alexandercoabad/AgilA32_PIO/README.md

    

# AgilA32 — an RV32I CPU with RP2040-compatible PIO for Tiny Tapeout (IHP SG13CMOS5L shuttle)

> **In one line:** an RV32I CPU written for this project, with RP2040-compatible
> PIO state machines on the same die, so the CPU can load, *and later replace*,
> the protocol engines at run time -- and can then halt itself while the PIO
> keeps running the protocol on its own.
>
> **Originality:** The CPU is written for this project, not derived from an existing open-source core; it follows the public RV32I specification, and the PIO follows the public RP2040 datasheet.
>
> **Third-party material:** the PIO block is an independent implementation, not affiliated with or endorsed by Raspberry Pi Ltd; "Raspberry Pi", "RP2040" and "Pico" are Raspberry Pi's trademarks, used only to say what the block is compatible with. Some programs in `pio/` are derived from the Pico SDK / pico-examples (BSD-3-Clause); see [`NOTICE.md`](NOTICE.md).
>
> Developed by Alexander Co Abad with the help of Claude AI (Sonnet 5.5).

Originally inspired by [Pineapple ONE](https://pineapple-one.github.io/),
a RISC-V CPU built entirely out of discrete 7400-series logic chips (no
FPGA, no microcontroller) -- the "just basic logic" idea of a minimal
RISC-V core is where this whole line of projects started.

## Try it and program it

- **Browser simulator** (the real RTL compiled to WebAssembly, with waveform, block diagram, LEDs, 7-segment display and example programs): https://alexandercoabad.github.io/agila32/
- **C and assembly programs**: `c/` holds a small C flow for the 44-byte GPIO-bootloader window with examples (blink, counter, chase, switches, PILIPINAS LASALLE on a 7-segment display); see `c/README.md`.
- **Submission checklist** with the evidence for each requirement: `SUBMISSION.md`.

## Protocol coverage

**Test counts** (all run by `make standalone-tests` in `test/`, and on every push by `.github/workflows/pio-tests.yaml`): **120 cocotb protocol tests**
(`test/test_pio_protocols.py`, `test_pio_swd.py` and `test_pio_can.py`, via `Makefile.proto`) **plus 17 PIO Verilog
testbenches**: 13 CPU-driven top-level demos (`tb_pio_cpu_uart.v`,
`tb_pio_cpu_i2c.v`, `tb_pio_cpu_multi.v`, `tb_pio_cpu_spi4.v`, `tb_pio_cpu_jtag.v`, `tb_pio_cpu_usb.v`, `tb_pio_cpu_i2c_slave.v`, `tb_pio_cpu_ps2.v`, `tb_pio_cpu_ws2812.v`, `tb_pio_cpu_ws2812_repeat.v`, `tb_pio_cpu_onewire.v`, `tb_pio_cpu_vga.v`, `tb_pio_cpu_can.v`) and 4 that
drive `pio.v` directly (`tb_pio_isa.v`, `tb_pio_uart.v`, `tb_pio_spi.v`, `tb_pio_vga.v`).

**Formal proofs and random tests** (added 30 Oct 2026, no change to `src/`): four unbounded SymbiYosys proofs of the PIO FIFO
(`pio_fifo.v`) and of one state machine (`pio_sm.v`) in `formal/` -- **all four pass** in the manual GitHub workflow `formal.yaml`
(run #3, 30 Oct 2026, commit `f03db8d`, 2 min 20 s) -- and 64 constrained-random cocotb protocol tests per seed
(`test/test_pio_random.py`: UART, SPI, I2C, PS/2; `pio-tests.yaml` run #54: seeds 1-5, 5 x 64 tests passed). See "Formal verification" below.

| Protocol | Runs on | Status | Verified by |
|---|---|---|---|
| UART TX | PIO (`uart_tx`) | Done | `tb_pio_uart.v` (cycle-exact 8N1 waveform, fractional divider), cocotb (integer, fractional and averaged dividers), end-to-end CPU demo `tb_pio_cpu_uart.v` |
| UART RX | PIO (`uart_rx_mini`) | Done | `tb_pio_uart.v` (TX+RX loopback, framing-error IRQ), cocotb (framing error, baud tolerance, two-SM loopback) |
| SPI master, modes 0-3 | PIO (`spi_master`, `spi_cpha1`, `spi_cpol1_cpha0`, `spi_cpol1_cpha1`) | Done | `tb_pio_spi.v` (mode 0: SCK period, `SYNC_BYP`), cocotb `test_spi_mode0`-`test_spi_mode3` (data both ways, SCK idle level and edge count, SCK period, MOSI setup/hold, fast SCK) |
| I2C master | PIO (`i2c`) | Done | cocotb (write, read, repeated-start register read, NAK -> IRQ 0, clock stretching), CPU demo `tb_pio_cpu_i2c.v` |
| SPI modes 0-3, CPU-driven | PIO reprogrammed by CPU at run time, CPU relays data | Done | `tb_pio_cpu_spi4.v` (one image, four modes back to back: SCK idle level, 16 edges, MOSI setup/hold, CS handled by the CPU, MISO byte read by the CPU and re-sent on MOSI in the next mode) |
| JTAG master (IEEE 1149.1 TAP walk), CPU-driven | PIO (`jtag`) | Done | `tb_pio_cpu_jtag.v` (CPU resets the TAP, reads the 32-bit IDCODE, loads IR = USER, writes the 16-bit USER register with the IDCODE bits it just read, reads it back; a pins-only TAP model checks every state, scan lengths 32/4/16/16, exactly 95 TCK pulses, TDI/TMS setup and hold, and that the CPU halts only after the last pulse) |
| UART -> SPI -> I2C on one state machine | PIO, reprogrammed by CPU at run time | Done | `tb_pio_cpu_multi.v` (all three waveforms, strictly in sequence) |
| I2C slave, write direction (`i2c_slave_rx`: address match, ACK, N data bytes into the RX FIFO) | PIO, 29 of 32 words | Done in simulation; bounded to `WRITE_BYTES` per transaction by design; needs SCL period >= 32 clocks (keep >= 40) | 5 cocotb tests (write, other address / read request ignored, buffer-full NAK, repeated START, single-byte mode with 0x00/0xFF/0x01/0x80) + `tb_pio_cpu_i2c_slave.v` (see below) |
| I2C slave, read direction (`i2c_slave_tx`: address match, ACK, bytes from the TX FIFO, clock stretching while the FIFO is empty) | PIO, 32 of 32 words | Done in simulation; same SCL limit | 4 cocotb tests (4-byte read, 3000-clock stretch, writes ignored, 12-byte read with FIFO refill) + the SCL-speed sweep |
| I2C multi-master master (`i2c_mm`: bit-level arbitration, clock synchronisation) | PIO, 27 of 32 words | Done in simulation. **No bus-busy detection**: a START is issued whether or not another master is mid-transaction and can destroy that transaction (2 of 8 timings tried); the host must wait for the bus to be free first (see docs/info.md) | 10 cocotb tests (no false arbitration loss, wins, loses and releases both lines then retries, loses inside the address byte, slower second master, identical frames where neither loses, loss decided on the last bit of a byte in both directions, read-versus-write to the same address in both directions) |
| One I2C device that is both slave directions (register file: write pointer, then repeated START + read) | PIO | Not possible as is: the two slave programs need 29 + 32 words and the instruction memory has 32; they can only be swapped at run time | -- |
| I2C slave driven by the CPU: master writes `A5 3C` to 0x42, CPU reads them off the RX FIFO, adds 1, swaps the PIO to the read-slave program, halts; master reads back `A6 3D` | PIO reprogrammed by the CPU between two slave programs | Done in simulation | `tb_pio_cpu_i2c_slave.v` (ACKs, bytes, CPU parked during the read; mutation-checked: CPU adding 2 instead of 1 fails the bench) |
| PS/2 keyboard, CPU bit-bang | CPU firmware over flash pages (not PIO) | Works only against a slowed-down keyboard | `tb_ps2_reader.v`, `tb_ps2_ascii.v` (the testbench holds each CLOCK level for 4000 clocks; a real keyboard's is 30-50 us, and one flash page switch costs about 3000 clocks -- see `docs/info.md`) |
| PS/2 keyboard receiver | PIO (`ps2_rx`, own state machine) | Done in simulation, at the `pio.v` level **and CPU-driven end to end** (`tb_pio_cpu_ps2.v`: real 10 kHz keyboard at 24 MHz; the CPU sleeps while 4 frames wait in the RX FIFO, then reads all 7 scancodes) | 7 cocotb tests against a PS/2 keyboard model: keystroke traffic incl. extended keys, 10 and 16.7 kHz CLOCK, 4-frame FIFO burst while the CPU is busy, FIFO overflow + recovery, idle-timeout resync after a partial frame, bad parity / stop bit reported to the CPU, and running next to an SPI master on another state machine |
| SPI LCD (ST7789) | CPU bit-bang (not PIO) | Done | `tb_st7789_driver.v` |
| CAN 2.0A/B (11 and 29 bit identifiers, data and remote frames), CPU-assisted | PIO (`can_tx` 20 words + `can_rx` 10 words = 30 of 32, two state machines; TXD = uo_out[0], RXD = ui_in[1] of an external CAN transceiver) | Done in simulation. TX: the PIO sends a frame the CPU has already CRC'd and bit-stuffed, reads the bus back at 75 % of every bit, stops at the first mismatch (lost arbitration / bit error, reported with the bit index) and reads the ACK slot; RX: raw capture of every frame (including the chip's own) after a hard sync on SOF, decoded afterwards by the CPU (`tools/can_frame.py`). **The CRC-15 and the bit stuffing run on the CPU because PIO has no XOR**, so this is not a real-time controller: the CPU has to keep the 4-deep FIFOs fed and drained (one word per 32 bit times). Bit rate = f_clk / (16 x CLKDIV) (24 MHz: CLKDIV 3 = 500 kbit/s, 6 = 250, 12 = 125); loop delay TXD -> RXD must be 0..7 clocks. **Not done**: resynchronisation after SOF (clocks must agree to about 0.2 %), bus-idle detection before SOF, automatic ACK of received frames, error counters and automatic error frames, CAN FD; not tried on a real bus or transceiver. | 25 cocotb tests against a CAN bus model with controller nodes (hard sync, 75 % sampling, destuffing, CRC, ACK, arbitration): CRC-15 against an independent GF(2) division, stuffing rules, 3000 random frames round-trip, 8 frame types on the wire (TXD edges exactly on the 16-tick grid, integer and fractional CLKDIV), unacknowledged frame, error flag command, back-to-back commands, arbitration lost / won / at every identifier bit, bit errors both ways with recovery, loop-delay margin, SYNC_BYP, RX of every frame type word for word against a Python reference model of the RX program, back-to-back frames, every partial-word length, error flag and stuff-violation capture, 7-word frames, a 14-frame mixed session; `tb_pio_cpu_can.v` (the CPU sends a frame that a bench node acknowledges bit for bit and reads back two RX captures) + `tools/can_mutation_sweep.py` (52 mutants of the two programs and of `can_frame.py`) |
| Low-speed USB host engine (1.5 Mb/s: token/data TX with NRZI + bit stuffing + EOP, reply RX) | PIO (`usb_ls`, 29 of 32 instruction words, one state machine) | Done in simulation at 24 MHz (CLKDIV 2); receive clock tolerance only about -0.5 % to +0.8 % (see below) | 7 cocotb tests against a low-speed device model (token waveform edge-by-edge, max-stuffing DATA1, IN -> DATA1 turnaround, NAK, receiver alone, 12-packet fuzz, clock-error sweep) + `tb_pio_cpu_usb.v` (CPU queues an IN token and halts; PIO sends it, turns the bus around and captures the 8-byte reply) |
| WS2812 / SK6812 LED strip ("NeoPixel"), CPU-driven | PIO (`ws2812`, 4 instructions, one state machine) | Done in simulation at 24 MHz (CLKDIV 3); a CPU-fed frame is limited to about 5 pixels (see below); not tried on a real strip | 5 cocotb tests against a strip model that decodes bits from pulse widths (exact 375 / 875 ns pulses and 1.25 us bits, 8 pixels back to back, latch between frames, a feed gap longer than the reset time splits the frame, 32-bit RGBW) and `tb_pio_cpu_ws2812.v` (CPU preloads four pixels, enables SM0, queues a fifth and halts; no pulse at the pad hand-over, 126 us low before the first bit, PIO finishes alone); the same bench also runs an RGBW firmware (32-bit pixels) and a 280 us-reset firmware (343 us low before the first bit) |
| WS2812 long strip (repeat colour) | PIO (`ws2812_repeat`, 15 instructions, one state machine) | Done in simulation: 300 pixels from ONE pair of FIFO words; borders stretch the LOW time to 1.0-1.5 us (outside the nominal windows, not tried on a strip) | 5 cocotb tests with exact HIGH and LOW widths at every border (runs, back-to-back runs, N = 1, RGBW, latch) + `tb_pio_cpu_ws2812_repeat.v` (CPU queues three colour runs with six FIFO words and halts; the PIO sends 60 pixels alone, every pulse exact) + `tools/ws2812_repeat_mutation_sweep.py` (18 mutants, all caught) |
| 1-Wire master (Maxim/Dallas, standard speed): reset + presence, bit slots, READ ROM | PIO (`onewire`, 31 of 32 instruction words, one state machine, open-drain DQ on pad 8) | Done in simulation at 24 MHz (CLKDIV 24 = 1 us tick); no overdrive speed, no strong pull-up, ROM search would be CPU code; usable clock window about -7.7 % to +15 % | 7 cocotb tests against a 1-Wire device model that checks every pulse (reset 480-960 us, presence timing for four device timings, absent device, write-slot edges, READ ROM with CRC-8, partial bit counts, read-0 hold margin, clock-tolerance sweep) and `tb_pio_cpu_onewire.v` (CPU resets the bus, sends READ ROM, reads and shows the 8 ROM bytes; CRC-8 checked) |
| SWD debug host (ARM Serial Wire Debug): line reset, JTAG-to-SWD switch, DP/AP register access, memory read/write through a MEM-AP | PIO (`swd`, 15 instruction words, one state machine; SWCLK on uo_out[0], SWDIO open-drain-style on pad uio4 with an external pull-up) | Done in simulation at the `pio.v` level: the CPU/host builds packets (request byte, parity, turnarounds, ACK, retry on WAIT) from two commands, `tools/pio_swd.py`; not tried on a real target, no CPU-driven demo | 18 cocotb tests against a protocol-strict SW-DP + MEM-AP model (ignores everything until the switch sequence, checks request parity, WAIT / FAULT / STICKYERR / WDATAERR, posted reads, auto-increment, host parity check, bus-contention monitor, SWCLK 4/4 ticks and SWDIO setup/hold, CLKDIV sweep) + `tools/swd_mutation_sweep.py` (20 mutants) |
| VGA 640x480 colour bars (Tiny VGA Pmod, uo_out) | PIO (`vga_frame` 23 words + `vga_line` 9 words = all 32, two state machines, CLKDIV 1) | Done in simulation at the pixel clock (one tick = one pixel); 8 colours at about 2/3 brightness (the LSB colour pins are not driven); 25.175 MHz gives exactly 59.94 Hz, this chip's 24 MHz gives 57.1 Hz (not tried on a real monitor) | `tb_pio_vga.v` (VGA monitor model: HSYNC 800 / 96 on every line, VSYNC 2 lines, 525 lines, 420000-clock frames, 480 picture lines of 8 exact 80-clock bars, black blanking, palette change applies next frame) and `tb_pio_cpu_vga.v` (CPU starts both machines with one write and halts; PIO draws 3 frames alone) |
| 10BASE-T (brief's stretch goal) | PIO | Not attempted: needs a frame buffer (a 4-deep FIFO holds 128 of ~576 bits; the CPU manages one word per ~3000 clocks), at least 40 MHz, and external magnetics | -- |

All results above are from simulation (RTL and gate-level). Nothing has been
measured on silicon yet.

## Lineage: AgilA8 -> AgilA32

Structurally and feature-wise, though, AgilA32 is the direct successor
to AgilA8 ([Sky130 original](https://github.com/alexandercoabad/AgilA8_microcontroller), [IHP port](https://github.com/alexandercoabad/AgilA8_IHP)) -- my own
earlier Tiny Tapeout project. Both are mine, and both belong to the
same "AgilA" line: *Agila* is Tagalog/Filipino for "eagle," and the
"A8" named that first core's 8-bit custom ISA. AgilA32 swaps that "A8"
for "A32" for exactly the reason it looks like: this is the 32-bit
RV32I successor to that 8-bit core, built under the same one-Tiny-
Tapeout-tile constraint AgilA8 already had to fit.

Most of what makes AgilA32 more than "just an RV32I core" is ported
from AgilA8 rather than designed fresh for this project:

- the shared QSPI engine driving flash + PSRAM (and now a generic SPI
  peripheral on CS2) off one state machine
- the GPIO bootloader protocol
- bank-switched flash execution
- the Timer/PWM peripheral -- register layout ported near-verbatim
  from AgilA8's `a8_peripherals.v`
- the generic SPI peripheral (`SPI_DATA`, `0xFD`) -- ported from
  AgilA8's `spi_ctrl.v`/CS2 front-end

The RV32I core itself -- the actual instruction set implementation --
is written fresh for this project (RV32I is a public, open
instruction-set standard, not something owned by either AgilA8 or
Pineapple ONE); it's the surrounding system AgilA32 needed to actually
be useful -- boot, memory-mapped I/O, external storage, peripherals --
that carries AgilA8's design forward, widened from 8 bits to 32.

- [Read the project datasheet](docs/info.md) — how it works, how to test it, pinout
- [AgilA8, the 8-bit predecessor this project is built on](https://github.com/alexandercoabad/AgilA8_IHP) (IHP port); the original [AgilA8 on Sky130](https://github.com/alexandercoabad/AgilA8_microcontroller)
- [Original Pineapple ONE project](https://pineapple-one.github.io/) (the origin-story inspiration)

**Scope note:** the original design has a 500 kHz clock, 512 kB program
memory, 512 kB RAM, and a VGA card — none of which fits in a TT tile
(~167×108 µm). This project keeps the RV32I instruction set and the
"no FPGA, just logic" philosophy, starting from a 256-byte address
space with no native video output, plus a small external RAM window
over the [Tiny Tapeout QSPI Pmod](https://github.com/mole99/qspi-pmod)
for anyone who wants more headroom than the on-chip memory alone
gives. A bit-banged SPI LCD driver (ST7789) now runs over that same
Pmod's GPIO, and a PS/2 keyboard reader is next to it feeding the same
external address space — see "Status" below.

## What is novel here (Jane Street protocol-emulator competition)

The brief asks for a chip that supports new protocols *after* fabrication,
and to say what the architecture makes possible beyond the RP2040's PIO.
Here is what this design does, with the test that backs each claim.

**1. The programmer lives on the die.** RP2040 PIO is driven by an external
Cortex-M0+. Here an RV32I core written for this project drives the PIO over a two-byte
window (`PIO_IDX`/`PIO_DATA`, with auto-increment) squeezed into an 8-bit
address space. No host microcontroller is needed: a flash image or the GPIO
bootloader is enough to bring the whole system up.
(`tools/pio_host.py`, docs/info.md "PIO")

**2. One state machine, three protocols, one image.** `tools/build_pio_multi.py`
builds a single flash image whose firmware reprograms the *same* PIO state
machine at run time: UART TX, then SPI mode 0, then I2C. Between phases it
disables and restarts the SM, overwrites instruction memory, and
reconfigures pins, shifting and clock divider. Pin hand-over is glitch-free
(UART idles high before it owns the pad, SCK is preset low, I2C pins are
handed over released). This is the "support new protocols after fabrication"
requirement demonstrated, not just claimed.
(`test/tb_pio_cpu_multi.v` checks all three waveforms against a UART
receiver, an SPI slave and an I2C slave, and that the phases ran strictly in
sequence.)

**2b. Four SPI modes, with the CPU in the data path.** `tools/build_pio_spi4.py`
builds one flash image that reprograms the same state machine for SPI mode 0, 1,
2 and 3 in turn. The CPU drives chip-select itself (`GPIO_OUT` bit 2), and it
relays data: the MISO byte it reads out of the RX FIFO in one mode is sent back
out on MOSI as the first byte of the next. A slave model that decodes the pins
only (per CPOL/CPHA, never looking at the PIO program) therefore checks the whole
chain slave MISO -> input sync -> autopush -> RX FIFO -> CPU load/store -> TX
FIFO -> autopull -> MOSI in every mode, plus SCK idle level, 16 edges, MOSI
setup/hold, and that SCK stays quiet while CS is high.
(`test/tb_pio_cpu_spi4.v`; mutation-checked, see `CHANGES_feature8.md`.)

**3. The CPU can leave; the protocol keeps going.** After queueing its last
word, the firmware executes `EBREAK`, which parks the core. The PIO finishes
the transfer alone -- in the I2C demo it generates the STOP condition with the
CPU halted. Protocol timing is therefore independent of firmware timing, and
the CPU can be halted for power or debugging without corrupting a transfer.
(`test/tb_pio_cpu_uart.v`, `test/tb_pio_cpu_i2c.v`)

**4. Stock Pico SDK programs run unmodified.** The PIO executes the RP2040
instruction set (JMP WAIT IN OUT PUSH/PULL MOV IRQ SET, side-set, delays,
autopush/autopull, IRQ flags, 16.8 fractional divider). Pico SDK `uart_tx`,
`uart_rx_mini` and `spi_cpha0` run as-is on pins 0-9, and `tools/pioasm.py`
assembles stock `pioasm` syntax, so existing PIO programs are a starting
point rather than something to rewrite.

**5. Open-drain buses on a real bidirectional pad.** Pins 8-9 (`uio[4]`,
`uio[5]`) use `PINDIR` as the true output enable, which is what makes I2C
possible. The polarity differs from the RP2040 (`PINDIR = 1` pulls the pad
low), so `pio/i2c.pio` has its side-set values swapped and
`tools/pio_i2c.py` complements the pindir bits it sends. Pins are only taken
from the LED/QSPI logic when their `PIN_OWN` bit is set, so reset behaviour
is identical to the pre-PIO chip and every earlier test still passes
unchanged.

**6. Verification against protocol peers, not just waveforms.**
- 120 cocotb protocol tests (77 in `test/test_pio_protocols.py` + 18 SWD in `test/test_pio_swd.py` + 25 CAN in `test/test_pio_can.py`, `make -f
  Makefile.proto`) drive `pio.v` over the same bus the CPU uses, against
  cycle-accurate peer models (`test/pio_tb_lib.py`): UART TX at integer,
  fractional and averaged dividers, UART RX including framing error and baud
  tolerance, two-SM UART loopback, SPI master modes 0-3 (plus fast SCK
  with `SYNC_BYP`), and I2C write, read, repeated-start register read, NAK
  raising IRQ 0, and clock stretching.
- `pio/ps2_rx.pio` (8 instructions) receives PS/2 frames on its own state machine, so the
  CPU no longer has to watch CLOCK edges: 7 cocotb tests check keystroke traffic at real
  10 kHz and 16.7 kHz clock rates, a 4-frame burst held in the RX FIFO while nobody reads it, an
  overflow that preserves the oldest four frames and recovers, an idle-gap timeout that drops a
  partial frame (removing it, or shortening it to 36 clocks, makes the tests fail), and SPI
  streaming on SM0 at the same time (every one of 1536 SCK edges fell inside PS/2 frames).
- SPI modes 2 and 3 idle SCK high without a pad-inversion override (the Pico SDK
  uses one; this block has none) by inverting the side-set values. The SPI slave
  model measures MOSI setup/hold, because a model that samples in the same cycle
  MOSI changes cannot tell a correct program from one whose data and clock edge
  coincide. Swapping the two programs makes the tests fail.
- The I2C slave model flags any SDA change while SCL is high, so START/STOP
  conditions are checked as protocol events, not just as edges.
- `tb_pio_isa.v` checks the semantics of every PIO instruction. While
  building it, three WAIT encodings in the supplied testbench turned out to
  have the wrong source field; they are fixed and documented in
  `CHANGES_feature6.md`.
- **Formal proofs of the PIO FIFO and state machine** (`formal/`, 30 Oct 2026). Unbounded proofs (every input sequence, no depth
  limit) with SymbiYosys and the `abc pdr` engine, on a copy of the design that has the properties inserted -- `src/` is not modified.
  `pio_fifo.v` (the TX and RX queue of every state machine): level and flags consistent, push into a full / pop of an empty FIFO change
  nothing, pointers agree with the level, a word pushed is the word popped (in order, bit-exact), and equivalence with a shift-register
  reference queue. `pio_sm.v` (any instruction word, any configuration, any FIFO / pin / IRQ state, reset at any time): never pops an
  empty TX FIFO or pushes into a full RX FIFO, OSR / ISR bit counters never above 32, quiet when disabled / between divided-clock ticks /
  in a delay slot, pin and direction writes only where the mask says, stall and forced-instruction PC rules, exact delay-slot length,
  restart state, and the clock divider period (integer dividers below 8.0 only). `formal/check_mutants.py` breaks a copy of the
  design 28 ways and every harness must reject each one (checked locally). **Not covered formally:** `pio.v` (registers, pin
  multiplexing, IRQ flags), `mem.v`, the CPU core and the QSPI engine. Details and limits: `formal/README.md`, `CHANGES_oct30_formal.md`.
- **Constrained-random protocol tests** (`test/test_pio_random.py`, 30 Oct 2026): 64 tests per seed on `pio.v` alone -- UART TX / RX
  (break frames, +-1.5 % baud error), SPI modes 0-3, I2C master (random clock stretching, wrong address) and PS/2 RX -- each checked
  against a reference model with bit-timing checks; seeds 1-6 passed locally, and `pio-tests.yaml` runs seeds 1-5: it passed on GitHub
  (run #54, push `f5e5942`, 30 Oct 2026, 25 min 11 s; every seed 64/64, no failures) (see `CHANGES_oct30_random_tests.md`).
- Gate-level tests run on the hardened netlist in CI (first run: 12/12 passing, including the PIO smoke test `test_pio_postlayout_echo_and_pulses`; 2,587 s, about 50 min for the `gl_test` job). Feature 20 adds a second post-layout test, the PIO signature test `test_pio_postlayout_signature`. In the gds run of 5-6 Oct 2026 (push `79f0997`, run #65) the gate-level job passed **13/13** on the placed netlist, signature test included: the signature test took 7,564 s (4.40 million simulated clocks) and the smoke test 3,444 s in that run; the `gl_test` job took 3 h 11 min and the whole `gds` workflow 5 h 52 min (`gds` 2 h 40 min, `gl_test` 3 h 11 min, precheck 8 min; the total is about `gds` plus `gl_test`, so precheck overlaps). That is inside GitHub's 360-minute limit per job, but it is a long wait for every push; run times also vary with the hosted machine.

**7. Designed for the synthesis flow, not just for simulation.** The first
CI synthesis of the PIO block stalled in Yosys' SAT-based `share` pass on the
variable-amount `<<`/`>>` operators in `pio_sm.v`. `pio_sm.v` now contains no
variable shifts: rotates, masks and 32-bit shifts are fixed-stage mux
shifters, with behaviour unchanged (all PIO testbenches still pass). The
`share` pass dropped from 145 analyses to 5 locally (28 s to 6 s) for about
+2% generic gates. `tools/sta.py` gives a quick pre-layout register-to-
register timing estimate from a Yosys JSON netlist and a liberty file.

**Honest limits.** Two state machines (the RP2040 has eight), a shared
32-word instruction memory, pins 0-9 only, and a 24 MHz clock in `info.yaml` (confirmed by GDS runs at that period: worst setup slack +20.6 ns in the slow corner in the latest run #122, i.e. a limit of about 47.5 MHz and roughly 2x margin (+20.2 ns and 46.5 MHz in run #90 and the earlier SG13G2 run); hold met in all corners).
The CPU costs about 3000 clock cycles per queued word (flash paging), so a
bus must be slower than that per byte for firmware to stay ahead of it -- the
FIFOs and the halt-and-continue behaviour above are how this is worked
around. All four SPI modes are also run end to end from CPU firmware (`tb_pio_cpu_spi4.v`); firmware must set the SCK bit in `GPIO_OUT` before the first `PIN_OWN`, and any forced instruction on an SM with plain side-set must carry the idle SCK level in bit 12, or SCK glitches. UART, SPI (modes 0-3) and I2C master are demonstrated in simulation. Low-speed USB host
is done in simulation only, with a receive clock tolerance of just about -0.5 % to +0.8 %; 10BASE-T
(the other stretch goal) is not attempted (it needs a frame buffer, at least 40 MHz and external
magnetics), and nothing has been measured on silicon yet.

## Portability: PDK-agnostic RTL, no macros
- **No PDK dependency in the RTL.** `src/*.v` and `*.vh` are plain synthesizable Verilog. No standard cell, I/O cell or other library primitive is instantiated (every instantiated module is defined in `src/`), and the only conditional compilation is `` `ifndef SYNTHESIS `` around simulation-only code. AgilA32's CPU-only version was hardened on Sky130 (previous target) and moved to IHP SG13 CMOS5L (current target) without an RTL change; only the flow files differ (`MIGRATION_TO_IHP.md`). The PIO block was added after that move and has been hardened on IHP only, so its portability rests on the RTL being generic, not on a second PDK run. (The 8-bit predecessor, [AgilA8 on Sky130](https://github.com/alexandercoabad/AgilA8_microcontroller), is a separate design tuned to Sky130; this claim is about AgilA32.)
- **No macros, no hard IP.** `src/config.json` lists no macros or extra files. All memories (the 16-bit PIO instruction memory, the CPU register file, the 48 B on-chip RAM) are Verilog arrays that synthesis turns into flip-flops, not SRAM macros. The trade-off is area: flip-flop memory is larger than SRAM, which is why the PIO instruction memory is only 32 words. In return, any open flow and PDK can build the design unchanged.
- **What is not portable.** The timing and area figures (24 MHz clock with a post-layout limit of about 47.5 MHz in the slow corner (run #122), 8x4 tiles, 13/13 gate-level tests) come from the IHP runs. A different PDK needs its own flow run to confirm them.

## Layout

Screenshot 2026-11-03 at 4 14 48 PM

https://gds-viewer.tinytapeout.com/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

## Status

- [x] Full RV32I base integer ISA (all loads/stores/branches/ALU ops;
      FENCE/ECALL/EBREAK decode as no-ops, no trap support yet)
- [x] Multi-cycle FSM core (fetch/fetch_wait/decode/exec/mem/mem_wait/
      writeback, 7 clock cycles per instruction -- the two `*_wait`
      states let the core stall on a `ready` handshake during external
      QSPI accesses; on-chip accesses see `ready` high immediately)
- [x] `tools/asm_pineapple.py` wraps every opcode the core above
      actually implements, not just the handful each script originally
      needed -- `SUB`, register-register `SLL`/`SRL`/`SRA`, `SLT`/
      `SLTU`, `SLTI`/`SLTIU`, `XORI`, `SRAI`, `LB`/`LH`/`LHU`, `SH`,
      `BGE`/`BLTU`/`BGEU`, and `LUI`/`AUIPC` are all now available to
      every script that builds on `Asm`/`PagedAsm`, confirmed against
      the real core (not just on paper) in `test/tb_alu_test.v`
- [x] Memory: 176 B combinational boot ROM (self-test + demo/listen
      loop + bootloader) + 48 B flip-flop RAM (4 B always on-chip
      scratch + 44 B bootloader-loadable/executable window, the latter
      redirectable to external flash via `FLASH_MODE`, and bank-
      switchable across that flash chip via `FLASH_PAGE`) + 16 B
      external PSRAM window over the QSPI Pmod + memory-mapped LED
      output (`0xF0`) / switch input (`0xF4`) / `FLASH_MODE` (`0xF8`) /
      `FLASH_PAGE` (`0xFC`)
- [x] **Timer/PWM peripheral**, ported from AgilA8's
      `a8_peripherals.v` (same bit layout/behavior): a free-running
      16-bit timer with enable/reset/overflow-flag registers
      (`TIMER_LO`/`TIMER_HI`/`TIMER_CTRL`/`TIMER_FLAG` at `0xF2`/
      `0xF3`/`0xF5`/`0xF6`) and an 8-bit free-running PWM generator
      (`PWM_DUTY`/`PWM_CTRL` at `0xF7`/`0xF9`), with the 2-bit
      `PIN_MUX` (`0xFA`) selecting whether `uo_out[7]` shows
      `LED_OUT[7]` (default), the PWM waveform, or the core's halted
      status -- see `test/tb_timer_pwm.v` and docs/info.md's
      "Timer / PWM" section
- [x] **EBREAK halts the core**, ported from AgilA8's `a8_core.v`
      `S_HALTED`/`halted` pattern: executing `EBREAK` parks the FSM in
      a new `ST_HALTED` state (no further fetches or memory activity)
      until the next reset, and the `halted` output it drives is what
      `PIN_MUX = 2'b10` exposes on `uo_out[7]` -- see
      `test/tb_ebreak_halt.v` and docs/info.md's "EBREAK halts the
      core" section
- [x] **Reprogrammable at runtime, no reflash/retapeout needed**: the
      boot ROM listens for a bootload request over `ui_in[0:2]`
      (DATA/CLOCK/START) and runs whatever program it receives
      straight out of on-chip RAM -- see `tools/build_boot_rom.py` and
      docs/info.md's "Reprogrammability" section
- [x] **Boot-timeout flash fallback**, ported from AgilA8's boot_rom:
      the listen loop above is bounded, not indefinite -- if START
      never comes, the boot ROM gives up on its own after a fixed
      number of iterations, sets `FLASH_MODE` itself, and falls into
      whatever's already sitting in external flash, so an unattended
      chip still boots something useful instead of blinking forever
      -- see `test/tb_boot_timeout.v` and docs/info.md's "Boot-timeout
      flash fallback" section
- [x] **Variable SPI clock divider**, ported from AgilA8's `SPI_CTRL`
      clock-divider field: `QSPI_CTRL` (`0xFB`) gates the shared QSPI
      engine's actual SCK rate (`clk`/2, `/8`, `/32`, `/128`), reset
      default is the slowest setting (matching AgilA8's own reset-safe
      default), sampled once per transaction so a mid-flight write
      can't corrupt a transfer already in progress -- `2'd0`
      reproduces the engine's original fixed-fast timing exactly, so
      nothing downstream needs to change to keep running as fast as
      before, it just isn't the default anymore -- see
      `test/tb_qspi_clkdiv.v` and docs/info.md's "Variable SPI clock
      divider" section
- [x] **Generic SPI peripheral (CS2)**, ported from AgilA8's
      `spi_ctrl.v`: `SPI_DATA` (`0xFD`) is a raw 8-bit transfer with no
      command/address framing, sharing CS2 with PSRAM "RAM B" -- **requires
      one board modification** (a trace cut on the QSPI Pmod, same as
      AgilA8's own CS2 always needed) before it can reach anything
      external; functionally inert until then -- see "General-purpose
      SPI (CS2)" below for the full caveat. An `SB` write clocks the
      byte out and simultaneously captures MISO; a plain `LBU` read
      returns the captured byte immediately, with zero wait cycles and
      no hardware retrigger, exactly AgilA8's `spi_ctrl.v` behavior --
      see `test/tb_spi_periph.v` and docs/info.md's "Generic SPI
      peripheral" section
- [x] **Bank-switched flash execution**: a bootloaded 1-instruction
      stub can hand off into external flash (`FLASH_MODE`), and
      `FLASH_PAGE` lets a running program page through a flash image
      far larger than the 44-byte on-chip execute window -- see
      docs/info.md's "Bank-switched flash execution" section and
      `tools/asm_pineapple.py`'s `PagedAsm`
- [x] **Real ST7789 LCD driver** (`tools/build_st7789_flash_image.py`),
      bit-banged SPI over `GPIO_OUT` (no dedicated SPI peripheral),
      built entirely on `PagedAsm` -- init sequence + fill loop
      verified byte-for-byte in `test/tb_st7789_driver.v`
- [x] **PS/2 keyboard reader**, bit-banged over two free `ui_in` pins:
      Step 1 (`tools/build_ps2_reader.py`) reads raw scancodes onto
      `GPIO_OUT`; Step 2 (`tools/build_ps2_ascii.py`) adds scancode-to-
      ASCII translation, including make/break-code and extended-code
      (`0xE0`) handling
- [x] **Hardened on the Sky130 shuttle CI (previous target)** at 6x2
      tiles, 53.8% routing utilization, 12,548 cells (excluding
      fill/tap), clean DRC/precheck (15/15 checks) and gate-level tests
      (11/11) -- see `.github/workflows/gds.yaml` run history
- [x] **Hardened on the Tiny Tapeout SG13G2 flow (earlier run, 6x4 tiles)** with
      the PIO block: 51.45% routing utilization, 34,053 cells (excluding
      fill/tap), clean lint, precheck 10/10 and gate-level tests 11/11
      (CI run #11, ~2h28m for the `gds` job -- expect a long build);
      with the feature 18 PIO smoke test added, gate-level tests 12/12
      (2,587 s, `gl_test` about 50 min instead of about 6); with the feature 20 signature test, gate-level tests 13/13 (`gl_test` 3 h 11 min)
- [x] **Hardened on the IHP SG13 CMOS5L flow (current target)** at **8x4 tiles**, placement density 58 %
      (CI run #90, 12-13 Oct 2026): 38,504 cells (excluding fill/tap), 41.8 % utilisation, clean lint, precheck
      9/9, gate-level tests 13/13; `gds` 4 h 34 min, `precheck` 4 h 47 min, `gl_test` 8 min. At 6x4 detailed routing
      did not converge; at density 60 % the precheck found one Metal2 spacing violation (M2.b) -- see `SUBMISSION.md`
- [x] **Synchronised with the organisers' template of 3 Nov 2026** (`ttihp-verilog-template`, `main`): the `gds.yaml`, `docs.yaml`,
      `fpga.yaml` and `test.yaml` workflows, `.devcontainer/` (PDK `ihp-sg13cmos5l`, LibreLane 3.1.0.dev4) and `.vscode/` are identical to the
      template, so the Tiny Tapeout actions now use the tag `@ttihp27a` (earlier runs, including #90, used the transitional tag `@ihp-cmos5l`).
      `test/Makefile` does the same gate-level job as the template (PDK cell models chosen from `$(PDK)`, UDP file read before the
      standard-cell file) plus this project's test list. `src/`, `info.yaml` and the hardened design are unchanged. A GDS / precheck /
      gate-level run on the new tag passed (**gds run #122**, push `ae18615`, 3 Nov 2026, same `src/` and `config.json` as run #90): success,
      5 h 51 min 41 s; `gds` 5 h 0 min, `precheck` 51 min 3 s (10/10 checks passed, including KLayout SG13CMOS5L DRC), `gl_test` 13 min 23 s
      (13/13), `viewer` 17 s. Layout figures differ from run #90 with the newer flow: 43,764 cells (excluding fill/tap) against 38,504,
      47.9 % utilisation against 41.8 %, wire length 3,373,594 um against 2,478,845 um (3,433 flip-flops in both). The extra cells come from synthesis: the
      newer flow (LibreLane 3.1.0.dev4 and a newer IHP PDK commit, against 3.1.0.dev3 in run #90) adds about 10,000 buffers (9 in #90),
      while timing-repair buffers fall from 8,762 to 6,225; the RTL, flip-flop count and `config.json` are unchanged. Setup slack at the
      slow corner is +20.6 ns (+20.2 ns in #90), hold slack +0.62 ns, 0 DRC / LVS / antenna errors in both runs. The `gds` job is longer than in #90 (5 h 0 min against 4 h 34 min), so its margin under GitHub's six-hour job limit is
      about 1 h; the precheck is much faster (51 min against 4 h 47 min).
- [x] **PIO block (protocol emulator)**: two RP2040-compatible PIO state
      machines + shared 32-word instruction memory + FIFOs at
      `PIO_IDX`/`PIO_DATA` (`0xFF`/`0xFE`), pins 0-9 (`uo_out[7:0]`,
      `uio[5:4]`). UART TX/RX, SPI master (modes 0-3) and I2C master run as Pico SDK
      programs (`pio/`), assembled by `tools/pioasm.py`, loaded by
      `tools/pio_host.py` -- see docs/info.md's "PIO" section and
      `CHANGES_feature6.md`. Built for the Jane Street protocol-emulator
      ASIC competition (hardened at 8x4 tiles).
- [x] Test suites (see "Testing locally" below): on-chip
      cocotb regression (self-test, demo counter, full bootload-and-run),
      95 cocotb PIO protocol tests, and 31 standalone Icarus testbenches
      (15 CPU and peripheral, listed next, plus the 16 PIO ones from the
      protocol table above) -- QSPI engine
      bit-level protocol, external-window integration via direct bus
      driving, full CPU-driven external load/store, self-test/bootload,
      `FLASH_MODE` handoff to external flash, `FLASH_PAGE`
      bank-switched flash execution, the ST7789 LCD driver, the PS/2
      reader (raw scancodes, then scancode-to-ASCII translation), an
      instruction-encoding check for every opcode
      `tools/asm_pineapple.py` wraps, the Timer/PWM peripheral, the
      EBREAK-halt behavior, the boot-timeout flash fallback, the
      variable SPI clock divider, and the generic SPI peripheral
      (`test/tb_timer_pwm.v`, `test/tb_ebreak_halt.v`,
      `test/tb_boot_timeout.v`, `test/tb_qspi_clkdiv.v`,
      `test/tb_spi_periph.v`) -- all in `make standalone-tests` (run in CI by `.github/workflows/pio-tests.yaml`;
      `test.yaml` itself runs `make` only); all 12 on-chip cocotb tests + all 31 standalone tests (15 CPU and
      peripheral, 16 PIO) + the 95 PIO protocol cocotb tests currently
      passing in simulation (the workflow's first GitHub run on 4 Oct 2026 passed, 9 min 4 s)
- [x] **Formal proofs of the PIO FIFO and state machine** (30 Oct 2026): four unbounded SymbiYosys / `abc pdr` proofs in `formal/`
      (`pio_fifo.v` properties and reference-queue equivalence, `pio_sm.v` properties and clock-divider period), all passing in the
      manual `formal.yaml` workflow (run #3, push `f03db8d`, 2 min 20 s); all 28 mutants of the design rejected (39 harness checks), locally and in that run (`mutants` option ticked).
      Not formal: `pio.v`, `mem.v`, the CPU core, the QSPI engine; clock-divider timing only for dividers below 8.0.
- [ ] **Step 3, in progress (redesigned):** a bitmap font + terminal renderer
      tying the PS/2 keyboard to the ST7789 display, so keystrokes appear on
      screen. The first plan -- interleave the polled PS/2 reader and the
      bit-banged display driver in one program -- cannot work: this core has
      no interrupts, one flash page switch costs about 3000 clocks, a real
      PS/2 CLOCK edge arrives every 30-50 us (720-1200 core clocks at 24 MHz, against about 3000 clocks per flash page switch), and
      the current ST7789 fill spends about 17 pages per pixel. The plan now
      moves both time-critical jobs into the PIO. **Done (simulation only):**
      PS/2 reception on its own state machine (`pio/ps2_rx.pio`; the 4-deep RX
      FIFO holds frames while the CPU is busy). **CPU-driven demo done**
      (`tb_pio_cpu_ps2.v`, feature 13). **Still open:** a PIO glyph expander (1-bit
      font rows -> RGB565 pixels over SPI), the font, scancode-to-ASCII in
      the terminal loop, and the renderer itself. Nothing here has run on a
      real keyboard or display.
- [ ] Validate the external memory path against a real flash/PSRAM chip
      or a vendor-accurate behavioral model (currently only tested
      against a hand-written behavioral model, `test/spi_ram_model.v`)
- [ ] Widen the address bus beyond 8 bits to actually reach the QSPI
      Pmod's real multi-megabyte capacity (current external window is
      a fixed 64 bytes within the existing 256-byte address space)

## Repo layout

```
src/
  rv32i_defs.vh          opcode/state constants
  rv32i_core.v            the CPU: regfile, ALU, decode, control FSM
  mem.v                   boot ROM + RAM + external QSPI windows + LED/switch/FLASH_MODE/FLASH_PAGE registers
  boot_rom_body.vh        generated boot ROM bytes, `include`d by mem.v -- don't hand-edit
  qspi_shared_engine.v    single-line SPI master shared between flash (CS0) and PSRAM (CS1)
  tt_um_agila32.v   Tiny Tapeout top-level pin mapping (incl. QSPI Pmod pins on uio)
  pio.v, pio_sm.v, pio_fifo.v   PIO block: host registers/pins/IRQs, one state machine, FIFO
  config.json             LibreLane flow config (clock period, density, etc.)
pio/
  uart_tx.pio, uart_rx.pio, spi_master.pio, spi_cpha1.pio, spi_cpol1_cpha0.pio, spi_cpol1_cpha1.pio, i2c.pio   Pico SDK programs (i2c: side-set polarity swapped)
  ps2_rx.pio              PS/2 receiver (own program: 11-bit frames, idle-gap resync)
  ws2812.pio              WS2812 / SK6812 LED data line (4 instructions, side-set pin, idle low)
  ws2812_repeat.pio       WS2812 / SK6812 long strips: (N-1, pixel) word pair paints N identical pixels
  swd.pio                 SWD (ARM Serial Wire Debug) host: SWCLK + SWDIO, two commands (write n bits / read n bits)
  can_tx.pio, can_rx.pio  CAN 2.0 transmitter with bus readback (20 words) and raw bit capture (10 words); CRC and stuffing on the CPU
  onewire.pio             1-Wire master (reset/presence, write and read slots; command word per transfer)
  vga_frame.pio, vga_line.pio   640x480 VGA colour bars on the Tiny VGA Pmod (two state machines, 23 + 9 words)
  jtag.pio                JTAG master (TAP walk, IDCODE / USER register scans)
  usb_ls.pio              low-speed USB host engine (NRZI, bit stuffing, EOP; 29 words)
  i2c_mm.pio              I2C multi-master (arbitration, clock synchronisation; 27 words)
  i2c_slave_rx.pio, i2c_slave_tx.pio   I2C slave receive / transmit programs (swapped by the CPU at run time)
tools/
  gen_random_init.py      lists the flip-flops that rst_n does not clear and writes test/random_init.vh (start-up test, RANDOM_INIT)
  build_boot_rom.py       assembles the boot ROM (self-test + demo/listen loop + bootloader)
                          into src/boot_rom_body.vh -- run this and re-copy its output if you
                          change what the boot ROM itself does
  asm_pineapple.py         RV32I assembler (Asm, wrapping every opcode the core implements) +
                          PagedAsm, the FLASH_PAGE bank-switching helper every *_flash_image.py
                          builder below shares
  build_flash_handoff_stub.py  1-instruction stub bootloaded over ui_in to hand off into flash
  build_flash_canary.py    tiny known-good flash program, for confirming the handoff mechanism alone
  build_flash_pagetest.py  synthetic 4-page program exercising switch_to()/switch_to_computed()
  build_st7789_flash_image.py  real ST7789 LCD driver, PagedAsm-based, bank-switched
  build_ps2_reader.py      PS/2 keyboard reader, Step 1: raw scancode -> GPIO_OUT
  build_ps2_ascii.py       PS/2 keyboard reader, Step 2: scancode -> ASCII translation
  gl_echo.pio / gl_pulses.pio   (in pio/) programs of the post-layout smoke test, built by tools/build_pio_gl_smoke.py
  gl_sig0.pio / gl_sig1.pio     (in pio/) programs of the post-layout signature test, built by tools/build_pio_gl_sig.py
  pioasm.py, pio_host.py, pio_i2c.py, build_pio_uart.py, build_pio_i2c.py, build_pio_multi.py, build_pio_spi4.py, build_pio_jtag.py, build_pio_onewire.py, build_pio_vga.py   PIO assembler/disassembler, flash-image host library, UART demo
  build_pio_ps2_rx.py, build_pio_usb.py, build_pio_ws2812.py, build_pio_ws2812_repeat.py, build_pio_i2c_slave.py   more CPU-driven PIO flash images (each is paired with a tb_pio_cpu_*.v)
  pio_i2c.py, pio_i2c_mm.py, pio_i2c_slave.py, pio_usb.py   host-side helpers / transaction models used by the cocotb tests
  i2c_slave_mutation_sweep.py   breaks the I2C slave programs one line at a time and checks the tests catch each mutant
  onewire_mutation_sweep.py     same for the 1-Wire master program (23 mutants)
  swd_mutation_sweep.py         same for the SWD host program (20 mutants)
  can_mutation_sweep.py         same for the two CAN programs and can_frame.py (52 mutants)
  can_frame.py                  CAN helpers: CRC-15, bit stuffing, frame encode / parse, TX command words, RX capture decoder and reference model
  build_pio_can.py              CAN CPU-demo flash image (+ test/pio_can_expect.vh) for tb_pio_cpu_can.v
  pio_swd.py                    SWD packet helpers (request byte, parity, command words, register addresses) for the tests and firmware
  vga_mutation_sweep.py         same for the two VGA programs (23 mutants)
  gl_smoke_mutation_sweep.py   same for the post-layout smoke test (16 mutants of the two programs and pio_sm.v)
  gl_sig_mutation_sweep.py     same for the post-layout signature test (40 mutants of the two programs, pio_sm.v and pio.v; 38 caught, 2 listed as survivors)
  ws2812_repeat_mutation_sweep.py   same for the WS2812 repeat-colour program (18 mutants)
  mutation_common.py            shared engine of the mutation sweeps
  sta.py                  quick pre-layout register-to-register timing estimate from a Yosys JSON netlist + liberty file
  build_alu_test.py        standalone program exercising every asm_pineapple.py opcode, for tb_alu_test.v
formal/
  run.sh                  four unbounded proofs (about 1 minute); `bash run.sh --mutants` also runs check_mutants.py (GitHub run #3: 2 min 20 s in total)
  fifo_props.vh, pio_fifo_formal.v, pio_fifo.sby   FIFO properties P1-P4 and equivalence with a reference queue
  sm_props.vh, pio_sm.sby                          state-machine properties S1-S8 (any instruction, configuration and FIFO / pin / IRQ state)
  instrument.py           writes a COPY of the design in formal/build/ with the properties inserted (src/ is never modified)
  check_mutants.py        28 deliberately broken copies of the design; every harness must reject each one
  README.md               what is proven, the limits, the toolchain note
test/
  tb.v, test.py           cocotb testbench: self-test pass/fail, demo counter, full bootload-and-run
  test_pio_random.py      64 constrained-random cocotb protocol tests per seed on pio.v (UART, SPI, I2C, PS/2); Makefile.random, PIO_RANDOM_SEED / PIO_RANDOM_N
  test_pio_gl.py          cocotb post-layout smoke test (also runs in the gate-level CI job): PIO echo + pulse programs through the pads; image `pio_gl_smoke_flash_image.hex`
  test_pio_gl_sig.py      cocotb post-layout signature test (feature 20): in / out / mov / jmp / wait forms, side-set PINDIRS, autopush/autopull, input synchroniser and the open-drain pads 8/9, compared with golden values; image `pio_gl_sig_flash_image.hex`
  tb_check.v              standalone: same three scenarios as a single self-contained Icarus testbench
  tb_qspi_engine.v        standalone: QSPI engine bit-level protocol + byte-order check
  spi_ram_model.v         behavioral single-line SPI RAM model (flash CS0 and PSRAM CS1), for the tests below
  tb_mem_ext.v            standalone: external window via direct bus driving + real engine + spi_ram_model
  mem_extmem_test.v       copy of mem.v with a test program in place of the boot ROM
  tb_core_ext.v           standalone: the real CPU running that test program against the external window
  tb_flash_handoff.v      standalone: bootloaded stub hands off into a small flash-resident program
  tb_flash_paging.v       standalone: FLASH_PAGE bank-switching across a synthetic multi-page program
  tb_st7789_driver.v      standalone: the real ST7789 driver, byte stream reconstructed and checked
  tb_ps2_reader.v         standalone: raw PS/2 frames -> GPIO_OUT (Step 1)
  tb_ps2_ascii.v          standalone: PS/2 frames -> translated ASCII on GPIO_OUT (Step 2)
  tb_qspi_clkdiv.v        standalone: QSPI_CTRL clock-divider timing, engine-level and through mem.v
  tb_spi_periph.v         standalone: generic SPI peripheral (SPI_DATA, CS2), engine-level and through mem.v
  tb_pio_isa.v, tb_pio_uart.v, tb_pio_spi.v, tb_pio_cpu_uart.v, tb_pio_cpu_i2c.v, tb_pio_cpu_multi.v, tb_pio_cpu_spi4.v, tb_pio_cpu_jtag.v, tb_pio_cpu_onewire.v, tb_pio_vga.v, tb_pio_cpu_vga.v, tb_pio_cpu_can.v, test_pio_protocols.py, test_pio_swd.py, test_pio_can.py, pio_can_lib.py   PIO block tests (see docs/info.md)
  alu_test_mem.v          minimal flat ROM+RAM harness (not mem.v) used only by tb_alu_test.v
  tb_alu_test.v           standalone: every asm_pineapple.py opcode, run through the real core, checked
                          against hand-computed register values
c/                        C flow for the 44-byte bootloader window, examples (blink, counter, chase, switches, PILIPINAS); see c/README.md
SUBMISSION.md             contest submission checklist with the evidence for each requirement
info.yaml                 Tiny Tapeout project metadata (title, pinout, tiles...)
docs/info.md              project datasheet shown on the Tiny Tapeout site
```

## How the boot ROM works

On every reset, the boot ROM self-tests the external QSPI PSRAM
(result latched into `uo_out[7]`), then loops forever incrementing a
demo counter into `uo_out[3:0]` while listening on `ui_in[0:2]` for a
bootload request -- assert START and stream over a new program at any
time, and the chip runs it immediately out of RAM, no reflash or
retapeout needed. Full protocol, address map, pinout, and the
`FLASH_MODE`/`FLASH_PAGE` opt-in for booting from (and paging through)
external flash are in [docs/info.md](docs/info.md).

## Testing locally

```
cd test
pip install -r requirements.txt
make                    # cocotb: self-test, demo counter, full bootload-and-run, PIO post-layout smoke and signature tests (test_pio_gl.py, test_pio_gl_sig.py)
make standalone-tests   # QSPI engine, clock divider, generic SPI peripheral, external-window, full-CPU,
                         # self-test/bootload, FLASH_MODE handoff, FLASH_PAGE bank-switching, ST7789 driver,
                         # PS/2 reader/ASCII, asm_pineapple.py instruction-encoding tests, all PIO
                         # testbenches (pio.v level and CPU-driven, incl. 1-Wire, VGA and CAN), and at the
                         # end the 120 cocotb PIO protocol tests (Makefile.proto)
make benches            # only the Icarus testbenches (about 5 minutes)
make RANDOM_INIT=3      # start-up test: every flip-flop that rst_n does not clear starts with random contents (also: make benches RANDOM_INIT=3)
make -f Makefile.proto COCOTB_TEST_FILTER=test_onewire_read_rom   # one protocol test (the longest,
                         # test_onewire_clock_tolerance, takes about 80 s)
```

The PIO testbenches need Icarus Verilog (`apt-get install iverilog`); the cocotb ones need
`pip install -r requirements.txt`.

`.github/workflows/test.yaml` runs only `make` (the on-chip cocotb tests) on every push. `make standalone-tests` (the 32 Icarus
testbenches and the 120 protocol tests) has its own workflow,
`.github/workflows/pio-tests.yaml`, which runs on every push and fails on any `FAIL` log or `<failure` in `results.xml`; started by hand with
`mutation_sweeps` ticked it also runs the mutation sweeps (eight: 1-Wire, VGA, WS2812 repeat, I2C slave, SWD, CAN, gate-level smoke test, gate-level signature test). Its first run on GitHub (4 Oct 2026, push `5de56c9`)
passed: 76/76 cocotb protocol tests, no failures, every bench log ending in PASS, job time 9 min 1 s (9 min 4 s total). The run after the SWD host was added (feature 19) passed 94/94 cocotb protocol tests (76 + 18 SWD), no failures or errors, and all 33 bench logs ending in PASS, in 4 min 28 s total (push `03013ea`, 4 min 25 s for the job; run time depends on the GitHub-hosted machine the job lands on and has varied between about 4 and 9 minutes). The run after the CAN PIO was added (feature 21, 7 Oct 2026) passed 120/120 cocotb protocol tests (77 + 18 SWD + 25 CAN), no failures or errors, all 34 bench logs ending in PASS (including `tb_pio_cpu_can.v`), in 9 min 35 s (the cocotb run itself took 444 s on that runner).

## Formal verification

```
cd formal && bash run.sh              # four unbounded proofs, about 1 minute (Yosys, SymbiYosys, yosys-abc; abc pdr engine)
cd formal && bash run.sh --mutants    # also: all 28 broken copies of the design must be rejected (GitHub run #3: 2 min 20 s in total)
```

Proven for every input sequence: the FIFO invariants and bit-exact in-order data (P1-P4), equivalence of the FIFO with a reference queue,
and the state-machine rules S1-S7 plus the clock-divider period S8 (integer dividers below 8.0). The workflow `.github/workflows/formal.yaml`
is manual (`workflow_dispatch`, option `mutants`) and is not part of the Tiny Tapeout flow. Its first successful run on GitHub
(run #3, 30 Oct 2026, push `f03db8d`, 2 min 20 s, job 2 min 16 s) passed all four proofs (`pio_fifo_props` 4 s, `pio_fifo_equiv` 10 s,
`pio_sm_core` 1 s, `pio_sm_clkdiv` 20 s, each ending `DONE (PASS, rc=0)`; log artifact `formal-logs`); the only annotation was GitHub's
Node.js 20 deprecation warning for one of the actions. That run had the `mutants` option ticked: all 28 mutants were rejected (39 harness checks: 11 FIFO mutants against each of two harnesses, 15 state-machine, 2 clock-divider). What is **not** proven: `pio.v`,
`mem.v`, the CPU core and the QSPI engine (covered by the simulation tests above), that a PIO program implements a protocol correctly, and
clock-divider timing for dividers of 8.0 and above. See `formal/README.md`.

Mutation sweeps (each breaks a PIO program one line at a time on a temporary copy and checks that a test fails; `--list`
shows the mutants): `tools/i2c_slave_mutation_sweep.py` (29), `tools/onewire_mutation_sweep.py` (23), `tools/vga_mutation_sweep.py` (23),
`tools/ws2812_repeat_mutation_sweep.py` (18), `tools/swd_mutation_sweep.py` (20). All mutants are caught; the first runs of the 1-Wire and VGA sweeps each exposed a hole in the
tests, now closed (see `CHANGES_feature15.md`, `CHANGES_feature16.md`).

## External memory over QSPI

`uio[0:7]` are wired to the
[Tiny Tapeout QSPI Pmod](https://github.com/mole99/qspi-pmod): a
single-line SPI master (`src/qspi_shared_engine.v`) shared between an
external flash chip (CS0) and PSRAM (CS1). PSRAM backs a 16-byte
external RAM window at `0xE0-0xEF` in `mem.v`, always -- this is also
what the boot ROM's own power-on self-test probes. Flash only gets
selected once a *bootloaded* program writes `FLASH_MODE` (`0xF8`),
which redirects the 44-byte loadable window at `0xB4-0xDF` from
on-chip RAM to flash from then on; the boot ROM itself never asserts
CS0. From there, `FLASH_PAGE` (`0xFC`) lets a running program bank-
switch through a much larger flash image 44 bytes at a time -- see
`tools/asm_pineapple.py`'s `PagedAsm`, which the ST7789 driver and PS/2
reader both build on. The core's FSM stalls on a `ready` handshake
while an external access is in flight, and picks up exactly where it
left off once the SPI transaction completes — on-chip accesses are
unaffected and still get an immediate response. See `docs/info.md` for
the full address map and pinout.

This currently only uses a fixed handful of bytes of the Pmod's actual
multi-megabyte capacity at any one time (`FLASH_PAGE` reaches further
into flash by paging, not by widening the address space itself), since
the CPU's address bus is still 8 bits wide. Reaching the Pmod's real
capacity as a flat address space means widening `pc`/`mem_addr` and the
jump/branch immediate math throughout `rv32i_core.v` — a bigger
follow-up change, not yet done here.

### General-purpose SPI (CS2) - requires one board modification

A fourth front-end, `SPI_DATA` (`0xFD`) — a raw byte-oriented SPI
master intended for driving an external device (an LCD, an ADC,
another MCU) — shares the same physical lines using CS2, alongside
PSRAM "RAM B" (`PSRAM_BANK = 1`). **This requires one board
modification first**: on the stock QSPI Pmod, CS2 ("RAM B") is wired
directly to a second, populated PSRAM chip, not out to any external
connector pin. Per the Pmod's own documentation
([mole99/qspi-pmod](https://github.com/mole99/qspi-pmod)), each of its
three chip-select traces can be cut on the back of the board — doing
so for CS2 disables that second PSRAM chip (a 1k pull-up holds its
`/CS` disabled) and makes the pad available via a through-hole header
pin as a plain input or output. That's a documented, intended
modification on the board as sold, not a custom respin — and it
leaves flash (CS0) and PSRAM RAM A (CS1) untouched, so the external
flash window and the boot ROM's own self-test are unaffected either
way.

Until that trace is cut, this peripheral is functionally inert: CS2
still selects the live RAM B chip, so `SPI_DATA` transfers just talk
to that PSRAM with the wrong command protocol rather than reaching any
external device. A program should only ever use one of `PSRAM_BANK =
1` or `SPI_DATA`, never both, depending on what's actually populated
on its particular board — see `qspi_shared_engine.v`'s header and
docs/info.md's "Generic SPI peripheral" section for the full
explanation.

If you don't want to modify the board (or just want the simplest path
for something slow enough that bit-banging is a non-issue, like an
e-paper display), drive the external device over the GPIO pins in
software instead — `uo_out[6:0]` and `ui_in[7:0]` are on a separate
header from the QSPI Pmod's `uio` bus entirely, so they aren't
affected by any of the above either way. The ST7789 driver and PS/2
reader both already do exactly this (see "How the boot ROM works"
above and docs/info.md).

## What is Tiny Tapeout?

Tiny Tapeout is an educational project that aims to make it easier and cheaper than ever to get your digital and analog designs manufactured on a real chip.

To learn more and get started, visit https://tinytapeout.com.

## Resources

- [FAQ](https://tinytapeout.com/faq/)
- [Digital design lessons](https://tinytapeout.com/digital_design/)
- [Learn how semiconductors work](https://tinytapeout.com/siliwiz/)
- [Join the community](https://tinytapeout.com/discord)
- [Build your design locally](https://www.tinytapeout.com/guides/local-hardening/)

## What next?

- [Submit your design to the next shuttle](https://app.tinytapeout.com/).
- Share your project on your social network of choice:
  - LinkedIn [#tinytapeout](https://www.linkedin.com/search/results/content/?keywords=%23tinytapeout) [@TinyTapeout](https://www.linkedin.com/company/100708654/)
  - Mastodon [#tinytapeout](https://chaos.social/tags/tinytapeout) [@matthewvenn](https://chaos.social/@matthewvenn)
  - X (formerly Twitter) [#tinytapeout](https://twitter.com/hashtag/tinytapeout) [@tinytapeout](https://twitter.com/tinytapeout)
  - Bluesky [@tinytapeout.com](https://bsky.app/profile/tinytapeout.com)
