alexandercoabad/AgilA32_PIO/SUBMISSION.md

# Submission checklist - AgilA32 (Jane Street protocol-emulator ASIC contest)

Deadline: **18 Jan 2027**. Selection is announced in early February 2027, for the March 2027 IHP SG13CMOS5L shuttle.
This file lists each requirement from the organisers' October 2026 update and where to find the evidence.
Last updated 3 Nov 2026 (gds run #122 on the SG13 CMOS5L flow with the organisers' current action tag; earlier run #90; formal run #3 and pio-tests run #54 on 30 Oct 2026).

| Requirement | Where it is | Status |
|---|---|---|
| Public repository with RTL | `src/` (RTL), `pio/` (PIO programs) | Done; set the repository to **public** before submitting |
| Tests | `test/` (cocotb + Icarus benches), `.github/workflows/test.yaml`, `pio-tests.yaml` | Done: 13 on-chip cocotb tests, about 30 Icarus benches (`test/tb_*.v`), 120 directed PIO protocol tests, 64 constrained-random protocol tests per seed, `make -f Makefile.random` (seeds 1-5 passed on GitHub in `pio-tests.yaml` run #54, 25 min 11 s), 4 formal proofs plus 28 mutant checks (`formal/run.sh --mutants`; all passed on GitHub in `formal.yaml` run #3, push `f03db8d`, 2 min 20 s) |
| Passing GDS and precheck from the Tiny Tapeout flow | `.github/workflows/gds.yaml` | Done on the SG13 CMOS5L flow at 8x4 tiles. Latest: run #122 (push `ae18615`, `main`, 3 Nov 2026, action tag `@ttihp27a` as in the organisers' template of 3 Nov 2026, same `src/` as #90) succeeded in 5 h 52 min; gds 5 h 0 min, precheck 10/10 (51 min), gate-level 13/13 (13 min); 43,764 cells, 47.9 % utilisation. Earlier: run #90 (push `16b8345`, branch `try-density58`, 12-13 Oct 2026) succeeded in 9 h 22 min; gds 4 h 34 min, precheck 9/9 (4 h 47 min), gate-level 13/13 (8 min) |
| Architecture and instruction-set documentation | `README.md`, `docs/info.md`, `docs/AgilA32_Project_Documentation.pdf` (also at the repo root, with a `.docx`) | Done |
| Assembler / toolchain with example programs | `tools/asm_pineapple.py` (RV32I), `tools/pioasm.py` (PIO), `tools/build_pio_*.py` (one image per protocol), `c/` (C flow and examples) | Done |
| Write-up of the verification approach | Documentation Section 7; `test/README.md` | Done |
| Third-party code and trademarks | `NOTICE.md` (Pico SDK / pico-examples BSD-3-Clause notice, trademark statement); README | Done |
| Description of how AI tools were used | Documentation Section 11; credit line in `README.md` | Done |
| Uses `rst_n` | all state that matters is reset by `rst_n`; test with random start-up contents (see below) | Done |
| 24 digital pins at most | `info.yaml`, `src/tt_um_agila32.v` | Check again against the organisers' 8x4 template when it is released (expected mid-October) |

## Timing of the hardening flow (limit: 6 h for gds + gl_test together)

Runs #65 and #79 used the Tiny Tapeout SG13G2 flow at 6x4 tiles. The runs after that use the SG13 CMOS5L flow at 8x4 tiles, which is slower.

| Run | gds | gl_test | Whole workflow |
|---|---|---|---|
| #65 (6 Oct 2026) | 2 h 40 min | 3 h 11 min | 5 h 52 min |
| #79 (11 Oct 2026, SG13G2 flow, 6x4, QSPI divider set first in the gate-level images) | 2 h 35 min | 11 min | 2 h 46 min |
| #85/#88 (11-12 Oct 2026, CMOS5L flow, 8x4, density 60 %) | 5 h 47 min / 3 h 49 min | 10 min | precheck 4 h 28 min / 4 h 48 min; precheck failed with one M2.b violation |
| #90 (12-13 Oct 2026, CMOS5L flow, 8x4, density 58 %) | 4 h 34 min | 8 min | 9 h 22 min; precheck 4 h 47 min, passed 9/9 |
| #122 (3 Nov 2026, CMOS5L flow, tag `@ttihp27a`, 8x4, density 58 %, same source as #90) | 5 h 0 min | 13 min 23 s | 5 h 52 min; precheck 51 min, passed 10/10; 43,764 cells, 47.9 % utilisation |

The gds job on CMOS5L ranges from 3 h 49 min to 5 h 47 min between runs (5 h 0 min in run #122), so gds plus gl_test leaves a buffer of only about 1 to 2 h under the six-hour limit. Two other layout variants (density 55 %, clock 41 ns) hit the six-hour limit in gds. The precheck is a separate job; its KLayout DRC takes about 4.8 h on the 8x4 die.

## Tile size and the CMOS5L flow

- The design is hardened at **8x4 tiles**. At 6x4 detailed routing did not converge (congestion), so 6x4 is not met. The brief gives 6x4 as the current area limit and 8x4 as the planned maximum; the organisers' 8x4 template is expected in mid-October. **Ask the organisers** which size applies.
- `src/config.json` uses `PL_TARGET_DENSITY_PCT` 58. At 60 the precheck reported one Metal2 spacing violation (rule M2.b, 0.21 um, about 1 nm short at one corner near x 65.9 um, y 456.7 um); 58 gives a clean precheck. The flow is deterministic, so the same inputs give the same layout.
- The gate-level Makefile reads `<lib>_udp.v` before `<lib>_stdcell.v`; the CMOS5L cell library keeps its UDP primitives in a separate file.

## Start-up state (reset)

The register file, the RAM, the PIO instruction memory and the PIO FIFO memory have no reset on silicon. The tests start
them with random contents: `make RANDOM_INIT=<seed>` (cocotb, in `test/`) and `make benches RANDOM_INIT=<seed>` (Icarus
benches); the list of registers is generated by `tools/gen_random_init.py`. The seeds run in CI are listed in
`.github/workflows/pio-tests.yaml`. A program must still write a register, RAM byte or PIO word before reading it.

## Known limits (stated honestly)

- Not tested on silicon or an FPGA board for the C and 7-segment examples; they ran on the RTL compiled to WebAssembly.
- Formal verification covers `pio_fifo.v` and `pio_sm.v` only (`formal/`, unbounded proofs; clock-divider timing for dividers below 8.0). `pio.v`, the CPU core, `mem.v` and the QSPI engine are not formally verified. Constrained-random tests (`test/test_pio_random.py`) cover UART, SPI, I2C and PS/2 only; CAN, 1-Wire, JTAG, SWD, USB and WS2812 use directed tests and the mutation sweeps.
- Hardened at 8x4 only; 6x4 did not route. The Metal2 corner violation at density 60 % shows the layout is sensitive to small changes; re-run the flow after any change.
- Pads of the CMOS5L process are not characterised yet (organisers' statement); external QSPI flash / PSRAM timing is untested on hardware.
- Only the smoke and signature PIO tests run on the placed (gate-level) netlist.
- A design that is deselected loses its state; the program has to be loaded again.
