alexandercoabad/AgilA32_PIO/info.md

<!---

This file is used to generate your project datasheet. Please fill in the information below and delete any unused
sections.

You can also include images in this folder and reference them in the markdown. Each image must be less than
512 kb in size, and the combined size of all images must be less than 1 MB.
-->

## How it works

This is a minimal, from-scratch 32-bit RISC-V (RV32I) CPU. Originally
inspired by [Pineapple ONE](https://pineapple-one.github.io/) -- a
RISC-V computer built entirely out of discrete 7400-series logic chips
(no FPGA, no microcontroller) -- the "just basic logic" idea of a
minimal, from-scratch RISC-V core is where this whole line of projects
started.

Structurally and feature-wise, though, this project is the direct
successor to AgilA8 ([Sky130 original](https://github.com/alexandercoabad/AgilA8_microcontroller), [IHP port](https://github.com/alexandercoabad/AgilA8_IHP))
-- my own earlier Tiny Tapeout project. Both are mine, and both belong
to the same "AgilA" line: *Agila* is Tagalog/Filipino for "eagle," and
the "A8" named that first core's 8-bit custom ISA. AgilA32 swaps that
"A8" for "A32" for exactly the reason it looks like: this is the
32-bit RV32I successor to that 8-bit core, built under the same
one-Tiny-Tapeout-tile constraint AgilA8 already had to fit.

Most of what makes this project more than "just an RV32I core" is
ported from AgilA8 rather than designed fresh:

- the shared QSPI engine driving flash + PSRAM (and now a generic SPI
  peripheral on CS2) off one state machine
- the GPIO bootloader protocol
- bank-switched flash execution
- the Timer/PWM peripheral -- register layout ported near-verbatim
  from AgilA8's `a8_peripherals.v`
- the generic SPI peripheral (`SPI_DATA`, `0xFD`) -- ported from
  AgilA8's `spi_ctrl.v`/CS2 front-end

The RV32I core itself -- the actual instruction set implementation --
is written fresh for this project (RV32I is a public, open
instruction-set standard, not something owned by either AgilA8 or
Pineapple ONE); it's the surrounding system this project needed to
actually be useful -- boot, memory-mapped I/O, external storage,
peripherals -- that carries AgilA8's design forward, widened from 8
bits to 32.

It implements the full RV32I base integer instruction set (LUI, AUIPC,
JAL, JALR, all branches, all loads/stores, and all register-register /
register-immediate ALU operations). FENCE/ECALL/EBREAK decode but act
as no-ops -- there's no trap/exception handling in this version.

The core uses a multi-cycle FSM (fetch -> fetch_wait -> decode ->
execute -> memory -> mem_wait -> writeback), so every instruction takes
7 clock cycles. The two `*_wait` states exist so the core can stall on
a `ready` handshake during a multi-cycle external memory access (see
below) -- for on-chip accesses `ready` is already high the instant the
state is entered, so they cost exactly the same 2 extra cycles as any
other instruction. This keeps the design small and easy to reason
about, at the cost of speed -- which is fitting, since the original
Pineapple ONE ran at 500 kHz too.

Because a Tiny Tapeout tile is far too small for the original design's
512 kB program memory + 512 kB RAM + VGA card, this version uses a much
smaller 256-byte address space:

- `0x00-0xAF`: 176-byte **boot ROM**. This is implemented as pure
  combinational logic (a big case statement, generated by
  `tools/build_boot_rom.py`), not flip-flops -- flip-flops don't
  reliably power up to a known value on real silicon, but combinational
  logic becomes fixed gates at synthesis time, so the boot ROM is
  guaranteed to be there on every power-on, with or without any Pmod or
  host attached.
- `0xB0-0xDF`: 48-byte flip-flop-backed **RAM**, split in two:
  - `0xB0-0xB3`: always on-chip scratch, never affected by
    `FLASH_MODE` below. The boot ROM doesn't use these itself; free
    for whatever gets bootloaded.
  - `0xB4-0xDF`: the **loadable/executable window**. This is where the
    bootloader (below) writes a received program, and it's the exact
    same byte-addressed memory the CPU fetches instructions from --
    no separate instruction/data split, so a freshly-received byte is
    executable the instant it's written. When `FLASH_MODE` (below) has
    been set, reads of this range come from external flash (CS0)
    instead of on-chip RAM.
- `0xE0-0xEF`: 16-byte **external PSRAM window** ("RAM A" / CS1) on the
  [Tiny Tapeout QSPI Pmod](https://github.com/mole99/qspi-pmod), via a
  single-line SPI engine (`src/qspi_shared_engine.v`). Reads and writes
  here take many clock cycles (the core stalls on the `ready` handshake
  until the SPI transaction completes) instead of the single-cycle
  response everywhere else on this bus. This is also what the boot
  ROM's own self-test probes at power-on (see below).
- `0xF0`: memory-mapped **LED output register**, wired to `uo_out`.
- `0xF1`: memory-mapped **PSRAM_BANK register**, read/write, resets to
  0. See "PSRAM_BANK (RAM B)" below.
- `0xF2`/`0xF3`: memory-mapped **TIMER_LO/TIMER_HI**, read-only -- low/
  high byte of a free-running 16-bit counter. See "Timer / PWM" below.
- `0xF4`: memory-mapped **switch input register**, wired to `ui_in` --
  also the bootloader's DATA/CLOCK/START input, see below.
- `0xF5`: memory-mapped **TIMER_CTRL register**, read/write, resets to
  0. See "Timer / PWM" below.
- `0xF6`: memory-mapped **TIMER_FLAG register**, read/write, resets to
  0. See "Timer / PWM" below.
- `0xF7`: memory-mapped **PWM_DUTY register**, read/write, resets to
  0. See "Timer / PWM" below.
- `0xF8`: memory-mapped **FLASH_MODE register**, write-only,
  write-any-value-to-set. See "Reprogrammability" below.
- `0xF9`: memory-mapped **PWM_CTRL register**, read/write, resets to
  0. See "Timer / PWM" below.
- `0xFA`: memory-mapped **PIN_MUX register**, read/write, resets to 0.
  See "Timer / PWM" below.
- `0xFB`: memory-mapped **QSPI_CTRL register**, read/write, resets to
  `2'd3` (slowest). See "Variable SPI clock divider" below.
- `0xFC`: memory-mapped **FLASH_PAGE register**, read/write, resets to
  0. See "Bank-switched flash execution" below.
- `0xFD`: memory-mapped **SPI_DATA register**, read/write, resets to
  0x00. See "Generic SPI peripheral" below.

### What the boot ROM does

On every reset, the boot ROM (`tools/build_boot_rom.py`) runs first,
from `0x00`:

1. **Self-test**: writes `0xA5` to the first byte of the external PSRAM
   window, reads it back, and compares. The result is latched into
   `uo_out[7]` (0 = pass, 1 = fail) and stays there for the life of the
   program, so you can tell at a glance whether the QSPI Pmod is
   actually attached and answering.
2. **Demo / listen loop**: increments a 4-bit counter into
   `uo_out[3:0]` (same visible behavior as a simple blink demo) while
   polling `ui_in[2]` (START) every iteration. The same free-running
   counter driving that display also serves as a timeout count -- if
   START never comes, the loop gives up on its own after a bounded
   number of iterations (see "Boot-timeout flash fallback" below)
   instead of listening forever.
3. **Bootload**: once START is seen (before the timeout elapses), it
   bit-bangs in a length-prefixed program over `ui_in[0:2]` and writes
   it byte-by-byte into the `0xB4-0xDF` RAM window with plain store
   instructions, then jumps to `0xB4` to run it. See
   "Reprogrammability" below for the wire format.

### Reprogrammability

The chip can be given a brand new program to run after every power-on
or reset, with no reflashing and no new tapeout, over three `ui_in`
pins:

- `ui_in[0]` = DATA (host drives)
- `ui_in[1]` = CLOCK (host drives, one pulse per bit; the chip samples
  DATA on the high phase and waits for the low phase before the next
  bit -- a full handshake, no baud-rate matching needed)
- `ui_in[2]` = START (host asserts high to request a bootload)

Wire format: one length byte (MSB first), then that many program bytes
(MSB first each). The host can assert START at any point before the
boot-timeout fallback below fires. See `tools/build_boot_rom.py`'s
module docstring for the exact bit-level protocol and register usage.

`FLASH_MODE` (`0xF8`, write-any-value-to-set, sticky until reset) hands
the `0xB4-0xDF` window over to external flash (CS0) instead of on-chip
RAM. Normally this is something a *bootloaded* program opts into --
writing it lets a chip with a flashed QSPI Pmod attached be set up
(once, by something you bootload) to boot straight from flash on every
subsequent power-cycle, without the host re-pushing anything over the
wire. Reflashing that chip afterward is a normal SPI flash write, not a
new tapeout. The boot ROM's own bootloader path never touches
`FLASH_MODE` itself -- it always loads into on-chip RAM. The one
exception is the timeout fallback below, which is the boot ROM writing
`FLASH_MODE` itself, not anything bootloaded.

#### Boot-timeout flash fallback

Ported from AgilA8's boot ROM, which gives up on an unbounded wait for
a bootload and falls back to flash after a fixed number of iterations.
`ui_in[2]` (START) is polled every pass through the demo/listen loop
above; the same free-running counter that drives the visible `uo_out
[3:0]` blink also serves, unmasked, as a timeout count. Once that count
exceeds a fixed threshold (`TIMEOUT_SHIFT` in `tools/build_boot_rom.py`
-- currently a placeholder value sized for simulation, not real-world
wall-clock time) without START having gone high, the boot ROM gives up
waiting on its own: it writes `FLASH_MODE` itself and falls straight
into the same jump a completed RAM bootload would use, which now lands
on external flash (CS0) instead. An unattended chip -- reset with
nothing driving `ui_in` at all -- ends up running whatever program is
already sitting in its external flash, rather than blinking forever
waiting for a host that isn't there. A host that wants to bootload
instead can still do so at any point before the timeout elapses,
exactly as described above; nothing about the fallback changes the
bootload path itself.

#### The FLASH_MODE handoff stub, and why flash byte 0 is dead

`FLASH_MODE` takes effect the instant its write commits -- the very
next fetch already resolves to external flash. `tools/build_flash_handoff_stub.py`
is a deliberately tiny (one instruction, 4 bytes) program meant to be
sent over the normal bootload protocol above: it just writes
`FLASH_MODE` and lets the CPU's own natural `PC+4` pick up execution
from flash from there.

That one-instruction constraint isn't a size optimization, it's load
bearing: a 2-instruction version (write `FLASH_MODE`, then jump to
flash byte 0) looks like the more natural design and was tried, but
doesn't work. The redirect isn't scoped to "future bootloads" -- by the
time the stub's own second instruction would be fetched, `FLASH_MODE`
is already set, so *that* fetch is also redirected to flash instead of
retrieving the jump instruction sitting in RAM where the bootloader
actually put it. The upshot: `PC+4` after the stub is `LOAD_BASE+4`,
not `LOAD_BASE` -- flash byte 0 of whatever image is sitting on the
Pmod's flash chip is never fetched by anything. Both
`tools/build_flash_canary.py` (a tiny synthetic test program) and
`tools/build_st7789_flash_image.py` (below) reserve their own byte 0 as
an explicit `ADDI x0,x0,0` NOP rather than a real instruction that
happens to be unreachable. This is exercised end-to-end in
`test/tb_flash_handoff.v` -- confirmed empirically both ways (the
2-instruction version really does misfire) while developing that test.

#### Bank-switched flash execution (FLASH_PAGE)

The `LOAD_BASE-0xDF` window FLASH_MODE redirects is fixed at
`WINDOW_BYTES` (44 bytes / 11 instructions) -- that's baked into the
chip's own 8-bit unified address bus and isn't changing, but a real
flash chip's own address space is much bigger than that. `FLASH_PAGE`
(`0xFC`, read/write, resets to 0) lets a *running* program pick which
`WINDOW_BYTES`-sized slice of the flash chip currently shows up at that
fixed chip-address window: `ext_addr` becomes
`flash_page*WINDOW_BYTES + (addr-LOAD_BASE)` instead of just
`addr-LOAD_BASE`. An 8-bit page register reaches up to ~11KB of flash
this way -- comfortably past what the 44-byte window could ever run on
its own, and enough for the ST7789 driver below.

This doesn't turn flash into a flat address space the CPU can just walk
through, though: switching pages only changes what's *fetched* from the
same fixed chip addresses going forward, not the address range itself.
`PC` still physically increments through `LOAD_BASE..0xDF` and then off
the end into the PSRAM window regardless of `FLASH_PAGE` -- a page
switch has to end with an explicit jump back to `LOAD_BASE`, and that
jump runs into the *exact same* same-cycle-redirect hazard as the
handoff stub above, just repeating at every page boundary instead of
once: `FLASH_PAGE` takes effect for the very next fetch, which is
wherever in the (now new) page the jump instruction happens to be
sitting, not where the programmer wrote it in the old page.

`tools/asm_pineapple.py`'s `PagedAsm` class handles this by reserving
each page's last two instruction slots as an identical `SW
<next_page>,FLASH_PAGE(x0)` followed by an identical `JAL x0,LOAD_BASE`
trampoline, present byte-for-byte the same in *every* page -- so it
doesn't matter which page's copy of the trampoline actually ends up
executing after a switch. That leaves 8 usable instructions per page
(7 for page 0, since its own byte 0 is dead per the handoff stub
section above). `switch_to(page_num)` covers a compile-time-constant
target; `switch_to_computed()` covers a runtime-decided one (e.g. a
loop counter deciding "one more pass" vs "done") -- see that class's
own docstring for the convergent-branch requirement the latter depends
on. This is exercised end-to-end in `test/tb_flash_paging.v` against a
hand-built 4-page image (`tools/build_flash_pagetest.py`) that
exercises both.

#### Driving an ST7789 display from flash

`tools/build_st7789_flash_image.py` assembles a small ST7789 LCD driver
(SWRESET/SLPOUT/COLMOD/MADCTL/CASET/RASET/DISPON, then fills the
configured window with a solid color) meant to be pre-programmed onto
the external flash chip and reached via the handoff stub above. This
core's CS2 hardware only speaks the fixed `0x03`/`0x02` PSRAM command
protocol (see "PSRAM_BANK (RAM B)" below), not arbitrary SPI bytes, so
it's still not a fit for a display's own command set -- the driver
bit-bangs SPI over `GPIO_OUT` directly instead (`uo_out[0]`=SCK,
`uo_out[1]`=MOSI, `uo_out[2]`=DC, `uo_out[3]`=CS, held low for the
program's entire lifetime).

This driver is built entirely on `PagedAsm` (above), not a flat
`Asm()` program -- an earlier version used a flat program and silently
did not work: the driver's SPI byte-send routine alone (14
instructions) is already bigger than the single 44-byte window, so PC
would walk off the end into the PSRAM window mid-routine and start
executing wrong instructions, not fail cleanly. Nothing had exercised
bank-switching with a program that size before, so this went unnoticed
until it was actually simulated end-to-end (`test/tb_st7789_driver.v`,
which reconstructs the actual bit-banged SPI byte stream from
`GPIO_OUT` and checks it against the exact expected init sequence).

Two page-friendly patterns make this work: every byte this driver ever
sends is a compile-time Python constant, so each *bit* becomes its own
tiny page (a trivial ADDI+SW/ADDI+SW, no runtime shift register or bit
counter needed) rather than a callable subroutine -- there's no
"return to caller's page" concept `FLASH_PAGE` supports, so a
subroutine living in one page can't be `JAL`'d into from a different
page the way the old flat version's `SEND_BYTE` was. And the pixel
fill -- which can't afford one page per bit at real panel sizes, tens
of MB of flash for a single color -- is a small fixed ring of pages (16
bit-send pages + 1 control page) built *once* and reused per pixel via
`switch_to_computed()`, since every pixel sends the identical color
bytes; only the pixel counter's starting value scales with panel size,
not the flash image itself. See that file's own docstring for the full
design, and `tools/asm_pineapple.py` for the small RV32I assembler both
this and the boot ROM builder share.

#### Reading a PS/2 keyboard from flash

`tools/build_ps2_reader.py` assembles a small PS/2 keyboard receiver,
built the same way as the ST7789 driver above (a `PagedAsm` program
reached via the same flash-handoff stub), meant to be pre-programmed
onto the external flash chip and to run alongside or instead of the
LCD driver. `ui_in[7:3]` are free for whatever gets bootloaded (see
"How to test" below), and PS/2 needs only two of them: `ui_in[3]` =
CLOCK, `ui_in[4]` = DATA, both keyboard-driven and idle high. No
wiring changes to the chip itself -- this is a firmware addition, not
an RTL one.

Where the LCD driver's `PagedAsm` program is organized one page per
*bit* (every byte it sends is a compile-time constant, so each bit's
SPI pulse fits its own page), this driver is organized one page per
protocol *phase* instead: wait for CLOCK to fall, sample DATA, wait
for CLOCK to rise, repeated across the 11 bits of a PS/2 frame (start
bit, 8 data bits LSB-first, parity, stop). Like the LCD driver, each
data bit's destination position in the result byte is a compile-time
constant (`1<<n`, OR'd into an accumulator register that -- like the
LCD driver's pixel counter -- survives `FLASH_PAGE` switches just
fine, since paging only changes what gets *fetched*, not the CPU's own
registers), so no runtime shift register is needed on the way in
either. The accumulated scancode is written to `GPIO_OUT` (`uo_out`)
once a full frame has been received, then the whole thing loops back
to wait for the next one -- this core has no interrupts (see above),
so watching for a keypress is exactly this kind of explicit polling
loop, not something that can happen "in the background" of anything
else the chip might also be doing.

The parity and stop bits' clock edges are waited through (to stay in
frame sync) but their *values* aren't checked -- this is Step 1
("prove the mechanism", per the project's own scoping notes), not a
fully spec-compliant PS/2 host with parity-error recovery. Verified in
`test/tb_ps2_reader.v`, which bit-bangs several distinct real 11-bit
PS/2 frames at `ui_in[3]`/`ui_in[4]` (the same shape a real keyboard's
transmission would take, including odd parity) and confirms `uo_out`
lands on each scancode sent -- including after the first frame, to
confirm the state machine re-arms itself correctly rather than only
working once.

**Limit of this reader (added with the PIO receiver below).** `test/tb_ps2_reader.v` holds each
CLOCK level for 4000 clocks. A real keyboard clocks at 10-16.7 kHz, so its CLOCK edges are 30-50 us
apart: 720-1200 core clocks at the 24 MHz in `info.yaml` (30-50 at the old 1 MHz), and only 1500-2500 clocks at 50 MHz. One
flash page switch costs about 3000 clocks (`Note the CPU costs about 3000 clk per queued word`, below;
also the runtime of `tb_pio_cpu_spi4.v` divided by its 55 pages), and this reader waits for every edge in a
separate page, so it cannot keep frame sync with a real keyboard at any clock this chip is likely to run.
It is a correct state machine that was only exercised against a keyboard several times slower than a real
one (3-5x at the 24 MHz in `info.yaml`, about 100x at the old 1 MHz); the page-switch cost still exceeds a real half-period either way. `pio/ps2_rx.pio` (below) removes the dependence on CPU speed.

#### Step 2: scancode -> ASCII translation

`tools/build_ps2_ascii.py` builds on Step 1 (its receive state machine
is duplicated byte-for-byte, same register conventions -- there's no
mechanism to splice two `PagedAsm` scripts' pages together, so each
`*_flash_image.py` file in this project is self-contained) and replaces
Step 1's "just echo whatever byte was received" with real Scan Code
Set 2 framing awareness plus an ASCII lookup, so a genuine keypress on
a real keyboard shows up on `uo_out` as the letter typed, not a raw
scancode.

Scan Code Set 2 -- what essentially every PS/2 keyboard speaks -- frames
key *events*, not key *identities*: a plain byte is a make code (key
pressed), `0xF0` followed by that byte is a break code (key released),
and either can be preceded by `0xE0` for an extended key (arrows,
right-Ctrl, etc). Two persistent flag registers (surviving `FLASH_PAGE`
switches exactly like the accumulator already does) track break/
extended state across frames, so a key release or an extended key's own
code correctly produces **no** `GPIO_OUT` write at all, rather than Step
1's "every received byte, including `0xF0` itself and the released
key's code right after it, gets echoed" behavior. Only a genuine plain
make code gets translated and emitted. Shift and CapsLock state aren't
tracked (later-step scope, same philosophy as Step 1's parity/stop-bit
values) -- every letter and shifted-symbol key maps to its unshifted
form regardless of what's held down, and modifier keys themselves have
no table entry (translate to `0x00`, same as any other unmapped key:
function keys, Escape, arrows, etc).

The lookup itself has an unusual implementation forced by this chip's
constraints: there's no runtime-addressable byte array to put a
256-entry table into (on-chip RAM is 4 bytes once flash execution owns
the loadable window), and indexing directly into flash at an arbitrary
computed byte offset isn't something `FLASH_PAGE` supports -- it only
selects which fixed-size *page* is mapped in, not a byte offset within
one. So the table IS the page layout: `switch_to_computed()` (see
`asm_pineapple.py`) jumps to page number `TABLE_START + scancode`, one
of a couple hundred tiny generated pages that each do nothing but load
a constant ASCII value and switch to a shared "emit" page -- the
"lookup" is which page execution lands on, the same mechanism the
ST7789 driver's fill-ring control page already uses for a
runtime-computed pixel-loop target, reused here for keyboard input
instead.

That table has a hard ceiling worth knowing about if you extend it:
`FLASH_PAGE` (`0xFC`) is 8 bits, so `TABLE_START + scancode` can only
safely address scancodes up to `255 - TABLE_START` before it would
overflow -- and the write *wraps*, silently landing on whatever
unrelated page that wrapped number happens to name, rather than
saturating or faulting. `PROCESS_DISPATCH` bounds-checks against this
before computing the target and safely redirects anything over the
limit to the always-`0x00` page instead. This was a real bug caught
only by actually simulating a scancode in that range (`0xFF` happened
to wrap onto the shared emit page's own number and silently re-emitted
whatever stale ASCII value was left over from the *previous* real
keypress) -- worth remembering if you add table entries and the ceiling
ever needs to move.

Verified in `test/tb_ps2_ascii.v`: a plain make code, a make+break pair
of the same key (exactly one emit, the break itself produces none), an
extended make+break pair (fully consumed, no emit at all), an unmapped
key (`0x00`), several plain keys back-to-back (confirming the flags
don't get stuck set), and a scancode past the safe-dispatch ceiling
(confirming the bounds check above actually prevents the wraparound bug
it exists for, not just untested code that happens to look right).

### Portability

The RTL is PDK-agnostic and uses no macros. `src/*.v` and `*.vh` are plain synthesizable Verilog: no standard cell, I/O cell or other library primitive is instantiated (every instantiated module is defined in `src/`), and the only conditional compilation is `` `ifndef SYNTHESIS `` around simulation-only code. AgilA32's CPU-only version was hardened on Sky130 and moved to IHP SG13 CMOS5L without an RTL change (see `MIGRATION_TO_IHP.md`); the PIO block was added afterwards and has been hardened on IHP only, so its portability rests on the RTL being generic, not on a second PDK run. `src/config.json` lists no macros or extra files, and all memories (PIO instruction memory, CPU register file, on-chip RAM) are Verilog arrays that synthesis maps to flip-flops, not SRAM macros. The price is area, which is why the PIO instruction memory has 32 words. Timing and area figures (24 MHz clock, 46.5 MHz post-layout limit, 6x4 tiles) are from the IHP run; another PDK needs its own flow run to confirm them.

## How to test

Power up the chip (or run the testbench) and watch `uo_out[3:0]`
(LED0-LED3) count from 0 to 15 and wrap back to 0. `uo_out[7]` reflects
the self-test result (0 = QSPI PSRAM detected and answering correctly,
1 = not attached, not responding, or nothing plugged in). `ui_in[2:0]`
are reserved for the bootloader handshake (START/CLOCK/DATA);
`ui_in[7:3]` are unused by the boot ROM and available for whatever you
bootload.

To load a new program, hold `ui_in[2]` (START) high and clock in a
length-prefixed byte stream on `ui_in[1]`/`ui_in[0]` as described in
"Reprogrammability" above -- `test/test.py`'s `boot_send_program()`
helper (and `tools/build_boot_rom.py`'s own protocol) show the exact
sequence. To change what the *boot ROM itself* does (rather than what
gets bootloaded into it), edit `tools/build_boot_rom.py` and re-run it
to regenerate `src/boot_rom_body.vh`, which `src/mem.v` `` `include``s
directly -- don't hand-edit that file.

*PIO block tests, CI and mutation sweeps.* Besides the suites below, the PIO block has 94 cocotb protocol tests, 16 PIO Verilog testbenches
(12 of them CPU-driven end to end through the real top level) and five mutation sweeps (`tools/i2c_slave_mutation_sweep.py`,
`onewire_mutation_sweep.py`, `vga_mutation_sweep.py`, `ws2812_repeat_mutation_sweep.py`, `gl_smoke_mutation_sweep.py` (16), `gl_sig_mutation_sweep.py` (40); 29 + 23 + 23 + 18 one-line mutants, all caught; the signature sweep catches 38 of 40, see its test paragraph). `make standalone-tests` runs
everything; `.github/workflows/pio-tests.yaml` does so on every push (first GitHub run on 4 Oct 2026, push `5de56c9`: 76/76 cocotb tests passed, every bench log ending in PASS, 9 min 4 s), while `test.yaml` runs only `make`.
Everything above is simulation; none of the PIO protocols has been tried on real hardware or a real peer device.

Nine test suites cover different parts of this design (see `test/`):
`test.py` (cocotb) drives the real top-level module end-to-end --
self-test pass/fail with and without a simulated QSPI slave, the demo
counter, and a full bootload-and-run of a small program; `tb_check.v`
is a standalone Icarus testbench covering the same three scenarios
(self-test fail without a slave, self-test pass with one, bootload) in
one run; `tb_qspi_engine.v` checks the QSPI engine's SPI bit-level
protocol and byte ordering in isolation; `tb_mem_ext.v` exercises the
external RAM window by driving `mem.v`'s bus signals directly (as the
core's FSM would) through the real engine plus a behavioral SPI RAM
model (`spi_ram_model.v`); `tb_core_ext.v` closes the remaining gap
by running the *real* `rv32i_core` executing actual RV32I load/store
instructions (`mem_extmem_test.v` swaps in a small test program in
place of the boot ROM) against that same external window, confirming
the address decode, wait-state handshake, QSPI engine, and byte
ordering all work together when driven by the CPU itself rather than a
testbench standing in for it; `tb_flash_handoff.v` bootloads
`tools/build_flash_handoff_stub.py`'s stub over the real DATA/CLOCK/
START protocol with both a flash (CS0) and PSRAM (CS1) model attached
at once, and confirms execution actually continues from the right
external flash byte afterward -- see "The FLASH_MODE handoff stub, and
why flash byte 0 is dead" above for what this caught; `tb_flash_paging.v`
bootloads the same stub, then walks a hand-built 4-page flash image
through both `switch_to()` and `switch_to_computed()`, confirming
`GPIO_OUT` visits every page's distinct value in the right order,
including a self-loop; `tb_st7789_driver.v` runs the real
`PagedAsm`-based ST7789 driver against a simulation-scaled panel and
reconstructs the actual bit-banged SPI byte stream to check it against
the exact expected init sequence -- see "Driving an ST7789 display
from flash" above for what this caught (a flat, non-paged version of
this same driver that silently ran off the end of the flash window);
and `tb_ps2_reader.v` bit-bangs several real 11-bit PS/2 frames at the
`PagedAsm`-based keyboard reader and confirms `GPIO_OUT` lands on each
scancode sent, across multiple frames in a row -- see "Reading a PS/2
keyboard from flash" above; and `tb_boot_timeout.v` covers the
boot-timeout flash fallback above: Part 1 leaves START low forever and
confirms the boot ROM eventually sets `FLASH_MODE` on its own and
starts executing a canary program preloaded into external flash, with
no bootload ever attempted; Part 2 confirms a host that responds well
before the timeout still gets a normal RAM bootload, unaffected by the
new fallback path; and `tb_qspi_clkdiv.v` covers the variable SPI
clock divider above: Part 1 drives `qspi_shared_engine.v` directly and
confirms each `QSPI_CTRL` setting's SCK half-period and whole-
transaction cycle count exactly match the documented `clk`/2, `/8`,
`/32`, `/128` rates (including that `2'd0` reproduces the engine's
original fixed-speed timing bit-for-bit), and that a mid-flight change
never perturbs a transaction already in progress; Part 2 drives
`mem.v` directly and confirms `QSPI_CTRL` itself resets to `2'd3`,
reads back what's written, and that a write actually reaches the
engine and changes real external-access timing end to end in both
directions, with the same mid-flight-immunity guarantee holding
through the register path too; and `tb_spi_periph.v` covers the
generic SPI peripheral above: Part 1 drives `qspi_shared_engine.v`
directly and confirms a raw byte gets exactly 8 bits on the wire (no
cmd/addr phase), MOSI-first, with only CS2 asserted, and that a
write's simultaneously-captured MISO byte round-trips correctly; Part
2 drives `mem.v` directly (with a standing "echo slave" process on
MISO) and confirms `SPI_DATA` resets to `0x00`, a plain read never
touches hardware (zero wait cycles, zero SCK pulses), a write is a
real 8-SCK-pulse transfer that leaves flash/RAM-A untouched, and --
the actual point of this port -- repeated reads after a write keep
returning the same captured byte for free, never re-triggering a
transfer.

**Known limitation:** the external RAM/flash windows have only been
validated against the behavioral model in `spi_ram_model.v`, not a real
flash/PSRAM chip or a vendor-accurate behavioral model. Treat the
protocol-level correctness as tested, but not yet hardware-proven.

## External hardware

`uo_out[0:7]` can be connected to LEDs (with series resistors) --
`uo_out[3:0]` for the demo counter, `uo_out[7]` for the self-test
result; `ui_in[0:2]` can be connected to a host (microcontroller, or a
few switches/buttons for manual testing) to drive the bootloader
handshake, and `ui_in[7:3]` are free for whatever you bootload. Once a
bootloaded program takes over `uo_out` for its own purposes (e.g. the
ST7789 driver above, which bit-bangs SPI over `uo_out[0:3]`), it no
longer reflects the demo counter or self-test result. A PS/2 keyboard
can be wired to `ui_in[3]` (CLOCK) and `ui_in[4]` (DATA) for the
reader described above -- both idle high, both driven by the
keyboard, nothing else on the chip needs to change.

PIO pin use (pins 0-7 = `uo_out[0:7]`, pins 8-9 = `uio[4]`/`uio[5]`; a pad belongs to the PIO only once its `PIN_OWN` bit is set): the Tiny VGA
Pmod goes on `uo_out[7:0]` (R1 G1 B1 VSYNC R0 G0 B0 HSYNC; the PIO drives only the high colour bit of each channel, and the Pmod
wants 3.3 V), a WS2812 / SK6812 data line on `uo_out[0]` (a 5 V strip usually needs a level shifter), and I2C, 1-Wire and low-speed USB use pads 8/9
(`uio[4:5]`, which the QSPI Pmod also uses as SD2/SD3: whether a PIO device and the Pmod can share those pins has not been checked). Each protocol's
section below gives its exact wiring.

`uio[0:7]` are wired to the
[Tiny Tapeout QSPI Pmod](https://github.com/mole99/qspi-pmod) pinout:
`uio[0]`=CS0 (flash -- only ever asserted once a bootloaded program
sets `FLASH_MODE`; the boot ROM itself never asserts it), `uio[1]`=SD0/
MOSI, `uio[2]`=SD1/MISO, `uio[3]`=SCK, `uio[4:5]`=SD2/SD3 (held high,
unused in single-line mode), `uio[6]`=CS1 (PSRAM "RAM A", backs the
`0xE0-0xEF` window and the power-on self-test by default), `uio[7]`=CS2
(PSRAM "RAM B", backs that SAME `0xE0-0xEF` window instead once a
program writes `PSRAM_BANK` (`0xF1`) -- see "PSRAM_BANK (RAM B)" below).
The QSPI Pmod must be physically attached for `0xE0-0xEF` accesses (and
`FLASH_MODE` accesses of `0xB4-0xDF`) to behave -- everything else on
this chip, including the bootloader over `ui_in`, works standalone with
no external hardware at all.

#### PSRAM_BANK (RAM B)

The stock Tiny Tapeout QSPI Pmod board has a second, populated PSRAM
chip ("RAM B") already wired directly to CS2 -- no board modification
is needed to reach it, unlike AgilA8's CS2 (a generic-purpose SPI
front-end that requires cutting a trace on the Pmod before it can talk
to anything other than that same chip). RAM B speaks the exact same
single-line `0x03` READ / `0x02` WRITE protocol as RAM A.

Because this core's entire address space is only 256 bytes and already
fully mapped, RAM B isn't a second, separate address window the way
RAM A is -- there's no room left for one. Instead, `PSRAM_BANK` (`0xF1`,
read/write, resets to `0`) picks which chip the *existing* `0xE0-0xEF`
window is backed by:

- `PSRAM_BANK = 0` (reset default): `0xE0-0xEF` reaches RAM A (CS1) --
  identical to every revision before CS2 existed, including the boot
  ROM's own self-test, which runs before any program has touched this
  register and so always probes RAM A.
- `PSRAM_BANK = 1`: `0xE0-0xEF` reaches RAM B (CS2) instead.

Only one chip is reachable at a time through this window -- flip
`PSRAM_BANK` back and forth to talk to each in turn. This is the same
bank-switching idea `FLASH_MODE`/`FLASH_PAGE` already use for the flash
window, applied to the second PSRAM chip instead of adding a dedicated
window this address space has no room for.

#### Variable SPI clock divider

Ported from AgilA8's `SPI_CTRL` clock-divider field -- in AgilA8 that
field only ever gated its own standalone generic SPI peripheral (CS2),
never flash/PSRAM, which always ran at a fixed speed regardless of it.
This core unifies the two: `QSPI_CTRL` (`0xFB`, read/write, resets to
`2'd3`) gates `qspi_shared_engine.v`'s SCK rate for every front-end
through it -- flash, PSRAM, and the generic SPI peripheral below --
rather than giving the generic peripheral a second, separate divider
field the way AgilA8's own `CTRL` register did.

- `QSPI_CTRL = 2'd0`: SCK = `clk`/2 -- the fastest setting, and the
  exact fixed speed this engine always ran at before this register
  existed (bit-for-bit identical cycle count per transaction, confirmed
  in `test/tb_qspi_clkdiv.v`).
- `QSPI_CTRL = 2'd1`: SCK = `clk`/8.
- `QSPI_CTRL = 2'd2`: SCK = `clk`/32.
- `QSPI_CTRL = 2'd3` (reset default): SCK = `clk`/128 -- the slowest,
  reset-safe setting, matching AgilA8's own reset default. Left here
  by the boot ROM, which never touches `QSPI_CTRL` itself, exactly
  like `FLASH_MODE`/`FLASH_PAGE`/`PSRAM_BANK` -- it's there for
  whatever gets bootloaded (or runs from flash) to speed up once it's
  confirmed safe to do so.

`QSPI_CTRL` is sampled once per external transaction, at the moment
the engine accepts a new request, and latched for that transaction's
whole duration -- a write to `QSPI_CTRL` while a transfer is already
in flight can never corrupt it partway through; it only takes effect
starting with the *next* transaction. Confirmed both at the engine
level directly and through `mem.v`'s register in `test/tb_qspi_clkdiv.v`.

#### Generic SPI peripheral

Ported from AgilA8's `spi_ctrl.v`/`qspi_shared_engine.v` CS2 owner -- a
raw 8-bit SPI transfer with no command/address framing at all, for
talking to whatever non-flash/PSRAM SPI device a board happens to have
wired to CS2 (an ADC, another MCU, an LCD controller not already
covered by a dedicated driver, etc), unlike flash/PSRAM/RAM B's fixed
`0x02`/`0x03` command protocol.

`SPI_DATA` (`0xFD`) is the whole interface:

- **Write** (`SB`): clocks the written byte out MOSI-first over the
  same 8 SCK cycles that simultaneously capture whatever MISO returns,
  latching that captured byte.
- **Read** (`LBU`), no write: returns the last captured byte
  immediately, in a single cycle, *without* re-triggering any hardware
  transfer -- ported directly from AgilA8's `spi_ctrl.v` "plain read
  returns the last transfer's byte" behavior. A multi-byte exchange
  with a real device is therefore a sequence of write-then-read pairs,
  not one write followed by however many free reads the device might
  seem to offer.

Resets to `0x00` (nothing has been clocked in yet).

Shares CS2 with PSRAM "RAM B" (see "PSRAM_BANK (RAM B)" above) -- NOT
a separate pin; the stock Tiny Tapeout QSPI Pmod has no spare
CS-capable pin (`uio[4]`/`uio[5]` are the flash chip's WP/HOLD lines,
not general-purpose). Reaching a *different* device on CS2 needs the
same board-level trace cut AgilA8's own CS2 has always required. A
program should only ever use one of `PSRAM_BANK = 1` or `SPI_DATA`,
never both, depending on what's actually populated on its particular
board -- this RTL doesn't arbitrate between them, any more than it
ever has for AgilA8's own CS2.

#### Timer / PWM

Ported directly from AgilA8's `a8_peripherals.v` -- same bit layout
and behavior, just remapped onto this core's single unified 8-bit
address space instead of AgilA8's separate IMEM/DMEM split. Both
peripherals are plain free-running counters with no interaction with
the external-memory/`ready` machinery: they're read and written the
same single-cycle way `FLASH_MODE`/`FLASH_PAGE`/`PSRAM_BANK` already
are, so no wait states are ever introduced by touching them.

**Timer** -- a free-running 16-bit up-counter:

- `TIMER_LO`/`TIMER_HI` (`0xF2`/`0xF3`, read-only): low/high byte of
  the counter.
- `TIMER_CTRL` (`0xF5`, read/write, resets to `0`): bit 0 enables
  counting (the counter holds at its current value while this bit is
  0); bit 1 is write-1-to-reset -- writing it with bit 1 set zeroes
  the counter that same cycle, independent of whatever bit 0 is set
  to in the same write. Bits `[7:2]` are unused, read as 0.
- `TIMER_FLAG` (`0xF6`, read/write, resets to `0`): bit 0 is the
  overflow flag, set when the counter wraps `0xFFFF` -> `0x0000`.
  Sticky until cleared -- any write to this address clears it,
  regardless of the value written (matches AgilA8's TIMER_FLAG
  exactly). Bits `[7:1]` are unused, read as 0.

**PWM** -- an 8-bit free-running PWM generator, sharing the same
free-running counter idea:

- `PWM_DUTY` (`0xF7`, read/write, resets to `0`): 8-bit duty cycle out
  of a free-running 256-cycle period. `0xFF` is special-cased as
  always-on (rather than 255/256, matching AgilA8's PWM_DUTY).
- `PWM_CTRL` (`0xF9`, read/write, resets to `0`): bit 0 enables the
  waveform; while disabled the output is held low regardless of
  `PWM_DUTY`. Bits `[7:1]` are unused, read as 0.

**PIN_MUX** (`0xFA`, read/write, resets to `0`) selects what
`uo_out[7]` actually shows, since this core (unlike AgilA8, which has
a spare pin) has already committed all 8 `uo_out` bits to `LED_OUT`.
It's a 2-bit field (`[1:0]`), not a single bit:

- `PIN_MUX = 2'b00` (reset default): `uo_out[7]` = `LED_OUT[7]` --
  matches every revision before the Timer/PWM peripheral existed, so a
  program that never touches `PIN_MUX` sees exactly the old behavior,
  including the boot ROM's own self-test-result bit.
- `PIN_MUX = 2'b01`: `uo_out[7]` = the PWM waveform instead.
- `PIN_MUX = 2'b10`: `uo_out[7]` = the core's `halted` status -- high
  for as long as the core is parked in `ST_HALTED` after executing
  `EBREAK` (see "EBREAK halts the core" below). Ported from AgilA8's
  `GPIO_DIR[7]` halted-status mux (`a8_core.v`'s `S_HALTED`/`halted`),
  adapted to a 2-bit `PIN_MUX` field instead of a dedicated direction
  bit, since `PIN_MUX` already existed here and a third mode was
  cheaper than a second register.
- `PIN_MUX = 2'b11`: reserved, currently falls back to `LED_OUT[7]`
  (same as `2'b00`).

Existing code that only ever wrote `0` or `1` to this register keeps
working unchanged -- those values still select LED and PWM
respectively, since they occupy the low bit the same way the old
1-bit field did.

`uo_out[6:0]` always shows `LED_OUT[6:0]` regardless of `PIN_MUX` --
only bit 7 is muxed. See `test/tb_timer_pwm.v` for a standalone
testbench covering the counter, overflow flag, duty-cycle waveform,
and `PIN_MUX` wiring end to end (including the halted-status and
reserved modes), and `test/tb_ebreak_halt.v` for the `EBREAK`/halt
behavior itself.

#### EBREAK halts the core

`FENCE` and `ECALL` still decode as NOPs, same as every earlier
revision (no trap support). `EBREAK`, however, now actually halts the
core: on executing it, the FSM parks in a new `ST_HALTED` state --- no
further instruction fetches, no memory activity -- until the next
`rst_n`. The `halted` output stays high for the entire time the core
sits there (not a one-cycle pulse), and is what `PIN_MUX = 2'b10`
above exposes on `uo_out[7]`.

This is a direct port of AgilA8's `a8_core.v` `S_HALTED` state, with
one difference: AgilA8's 16-instruction encoding had a spare opcode to
dedicate to a real `HALT` instruction, while this core doesn't have
room to spare in the standard RV32I encoding, so `EBREAK` (opcode
`SYSTEM`, `funct3=000`, `imm[11:0]=0x001`) is repurposed as the halt
trigger instead -- close to EBREAK's usual "stop and hand control to a
debugger" role in real RISC-V, just without an actual debugger on the
other end. `tools/asm_pineapple.py`'s `Asm.EBREAK()` emits it.

#### PIO -- firmware-defined protocol engines (UART / SPI / ...)

AgilA32 carries a **PIO block**: two state machines that execute the
RP2040 PIO instruction set (JMP WAIT IN OUT PUSH/PULL MOV IRQ SET, with
side-set, per-instruction delay, autopush/autopull, IRQ flags, and a
16.8 fractional clock divider), one shared 32-word instruction memory,
and a 4-deep TX and RX FIFO per state machine. Each state machine
executes one instruction per divided-clock tick with deterministic,
cycle-exact timing, so a protocol is *a short program loaded after
fabrication* -- nothing about UART, SPI, etc. is hard-wired. Programs
written for the RP2040 (Pico SDK `uart_tx`, `uart_rx_mini`, `spi_cpha0`
...) run unmodified when they stay on pins 0-9 (`pio/` holds three of
them; `tools/pioasm.py` assembles the stock `pioasm` syntax).

**Bus interface.** The core's 8-bit address space was full, so PIO uses
two bytes: `PIO_IDX` (`0xFF`, bits[6:0] = register index, bit 7 =
auto-increment) and `PIO_DATA` (`0xFE`, a full 32-bit word to the
selected register). With auto-increment a whole program streams into
instruction memory with back-to-back stores. The register map is in the
header of `src/pio.v` (CTRL, IRQ, FSTAT, PIN_OWN, SYNC_BYP, PINS_IN,
PINS_OUT, INFO, IMEM 0x20-0x3F, and per-SM CLKDIV/EXECCTRL/SHIFTCTRL/
PINCTRL/INSTR/ADDR/TXF/RXF/FLEVEL at `0x40 + 0x10*n`).

**Pins.** PIO pins 0-7 = `uo_out[0..7]` (inputs read `ui_in[0..7]`);
pins 8-9 = `uio[4]`, `uio[5]` (true bidirectional, PINDIR is the real
output enable, so open-drain buses such as I2C are possible). A pin is
taken from the LED/QSPI logic only when its `PIN_OWN` bit is set, so
reset behaviour and every earlier feature are unchanged. Inputs pass a
2-flop synchroniser (per-pin bypass in `SYNC_BYP`; needed for fast SPI
MISO, exactly as on the RP2040).

**Host tooling.** `tools/pio_host.py` turns "load this PIO program,
configure the SM, start it" into a paged flash image (each PIO register
write costs several RV32I instructions and the on-chip execute window
is only 11 instructions). `tools/build_pio_uart.py` builds the demo:
the CPU loads `uart_tx`, starts SM0 at 128 clk/bit, queues `"Agil"`,
then executes `EBREAK` -- the core halts and **the PIO keeps
transmitting**.

**Known behaviour to be aware of.** A host-forced `OUT EXEC` / `MOV EXEC`
on a *disabled* state machine leaves the produced instruction pending; it
runs in place of the next program fetch once the SM is enabled.

**Tests.** `tb_pio_isa.v` (directed semantics of every instruction),
`tb_pio_uart.v` (SDK UART TX+RX loopback, cycle-exact 8N1 waveform,
framing-error IRQ, fractional divider), `tb_pio_spi.v` (SDK SPI master,
SCK period, SYNC_BYP behaviour), and `tb_pio_cpu_uart.v` (end-to-end:
real CPU + flash image + PIO in the real top level, CPU halted while the
last byte is still on the wire).

**Protocol tests (`test/test_pio_protocols.py`, `make -f Makefile.proto`).** The suite started with 26 cocotb
tests and has 76 now (I2C slave and multi-master, JTAG, low-speed USB, WS2812 including the repeat-colour program, and 1-Wire were added
later; each is described in its own section below). They drive `pio.v` over the same bus the CPU uses, against cycle-accurate peer models
(`test/pio_tb_lib.py`): register/FIFO behaviour; UART TX at integer, fractional and
averaged dividers, UART RX incl. framing error and baud tolerance, two-SM UART loopback;
SPI master modes 0-3 (plus fast SCK with `SYNC_BYP`; MOSI setup/hold measured); and I2C write, read,
repeated-start register read, NAK -> IRQ 0, and clock stretching; and the PS/2 receiver (see below), with the slave model
flagging any SDA change while SCL is high.

**I2C polarity.** The Pico SDK I2C program assumes an *inverted* pad output-enable. Here
`PINDIR = 1` pulls the pad low, so `pio/i2c.pio` has its `side` values swapped and
`tools/pio_i2c.py` complements the pindir bits it sends (data, ACK slot, START/STOP).
One bit is 32 PIO ticks, so SCL = clk / (32 * CLKDIV). `tools/sta.py` is a quick
pre-layout register-to-register timing estimate from a Yosys JSON netlist and a liberty file.

**SPI modes 2 and 3 (CPOL = 1).** `pio/spi_cpol1_cpha0.pio` (mode 2) and
`pio/spi_cpol1_cpha1.pio` (mode 3) are `spi_cpha0` / `spi_cpha1` with the side-set values
inverted, so SCK idles *high*. The Pico SDK gets CPOL = 1 by inverting the SCK pad with a GPIO
output override; this block has no such override, so the program does it instead. Timing and
wiring are otherwise identical to modes 0/1 (SCK = clk / (4 * CLKDIV), MOSI = OUT pin,
SCK = side-set pin, MISO = IN pin, 8-bit autopull/autopush, MSB first). Mode 2 samples MISO on the
falling edge and changes MOSI on the rising edge; mode 3 changes MOSI on the falling edge and
samples on the rising edge.

Handing SCK over to the PIO needs a specific order or the pad glitches (a spurious edge that a
slave would count as a clock):
1. Set SCK high in the CPU's own output register (`GPIO_OUT`, `0xF0`), because until `PIN_OWN` is set the
   pad is driven from there, not from the PIO.
2. Force `set pins, 1 side 1` (`0xF001`) with `SET_BASE = SIDESET_BASE = SCK`. The side-set value of a
   forced instruction is bit 12, so the plain `set pins, 1` (`0xE001`) would drive SCK low again.
3. Set the `PIN_OWN` bits (MOSI + SCK), then enable the state machine.

`test_spi_mode2` / `test_spi_mode3` check the data both ways, that SCK is high when the pad is
handed over, that there is exactly one falling and one rising edge per bit and SCK returns to
idle-high after the last bit, that the SCK period is `4 * CLKDIV` clocks, and that MOSI is stable
for at least one PIO tick before and after every sampling edge (a slave model that samples in the
same cycle MOSI changes would otherwise hide a program whose data and clock edge coincide).
These are `pio.v`-level tests; steps 1-3 above are documented but not yet exercised end to end
through the CPU and the top-level pad mux.

**CPU-driven I2C demo.** `tools/build_pio_i2c.py` builds a flash image in which the CPU loads
`pio/i2c.pio`, starts SM0 (SDA = `uio[4]`, SCL = `uio[5]`, CLKDIV 32 = 1024 clk per SCL period),
queues START / `0x50<<1|W` / `0xA5` / `0x3C` / STOP through the 4-deep TX FIFO (every push first
spins on `FSTAT.TXFULL`, `PioHost.tx_push_paced`), then executes `EBREAK`. The core is parked
before the STOP; PIO generates it alone. `test/tb_pio_cpu_i2c.v` checks this end to end against an
open-drain bus with a behavioural slave at 0x50 (all bytes ACKed, one START, one STOP).
Note the CPU costs about 3000 clk per queued word (flash paging), so the bus must be slower than
that per byte for the CPU to get ahead of it.

**One image, three protocols (the reprogrammability demo).** `tools/build_pio_multi.py` builds a
single flash image whose firmware reprograms the *same* PIO state machine at run time: UART TX
("Agil", pin 0), then SPI mode 0 (0xA5 0x3C, MOSI = pin 0, SCK = pin 1), then I2C (write C3 96 to
0x50, `uio[4]`/`uio[5]`), and finally `EBREAK` while PIO completes the I2C STOP alone. Between
phases the state machine is disabled and restarted (`CTRL` = restart | clkdiv-restart | FIFO-clear),
instruction memory is overwritten, and pins, shifting and clock divider are reconfigured. The CPU
sits in a busy loop (`PioHost.delay`) for each protocol to finish. `test/tb_pio_cpu_multi.v`
checks all three waveforms against a UART receiver, an SPI slave and an I2C slave, and that the
phases ran strictly one after the other. Hand-over is glitch-free: UART idles high before it
owns the pad, SCK is preset low before SPI owns it, and the I2C pins are handed over released.

**One image, four SPI modes, CPU in the data path.** `tools/build_pio_spi4.py` builds a second
reprogrammability demo: the same PIO state machine is reloaded for SPI mode 0, 1, 2 and 3, with
MOSI = `uo_out[0]`, SCK = `uo_out[1]`, MISO = `ui_in[2]` and CS_n = `uo_out[2]` driven by the CPU.
The CPU reads each mode's MISO byte from the RX FIFO and sends it out as the first MOSI byte of the
next mode, then shows the last one on the LED pads and halts. `test/tb_pio_cpu_spi4.v` decodes the
wire from the pins alone and checks idle level, edge count, MOSI setup/hold, relay, and that SCK is
silent while CS is high.

**JTAG: the CPU walks a TAP through the PIO.** `pio/jtag.pio` (24 words, original, no SDK
equivalent) is a TCK generator, TMS/TDI driver and TDO sampler: TDI = `uo_out[0]`, TMS = `uo_out[1]`,
TCK = `uo_out[2]`, TDO = `ui_in[3]`. The CPU is the JTAG probe software and decides every TAP move
by pushing header words (`n-1` in bits 4:0; bit 5 = shift data, else a TMS sequence; a data shift
takes TDI from the next word, drives TMS = 1 on the last pulse and pushes the captured TDO word).
`tools/build_pio_jtag.py` resets the TAP, reads the 32-bit IDCODE, loads IR = USER, writes the
16-bit USER register with the IDCODE bits it just read from the RX FIFO (a CPU relay), reads it
back, shows the low byte on the LED pads and halts: 95 TCK pulses. Because the ISR shifts right, a
32-bit scan returns the register itself and the low half goes straight back out LSB first. Two
firmware rules this demo taught: a scan is always also a write (a read-back that shifts zeros in
erases the register, so it shifts the same value back), and the last RX word arrives *before* the
trailing Exit1 -> Update -> RTI clocks, so the CPU must wait for the state machine to go idle
(`PioHost.wait_sm_idle`) before halting. `test/tb_pio_cpu_jtag.v` models the TAP from the pins alone.

**PS/2 receiver on the PIO (`pio/ps2_rx.pio`).** Eight instructions, no side-set, no output pins. CLOCK
= PIO pin 3 (`ui_in[3]`), DATA = pin 4 (`ui_in[4]`), the same wiring as the polled reader. Configure
`IN_BASE = 4` (`in pins, 1` samples DATA), `JMP_PIN = 3` (`jmp pin` tests CLOCK without blocking),
autopush at 11 bits, shift right. CLOCK is waited on with `wait ... gpio 3` (absolute pin number; edit the 3
if you rewire). The keyboard drives DATA valid while CLOCK is low, so the program samples on the falling
edge. Each frame arrives as one RX FIFO word with the frame in bits [31:21]:

    f = word >> 21;   start = f & 1;   data = (f >> 1) & 0xFF;   parity = (f >> 9) & 1;   stop = (f >> 10) & 1

The PIO does not judge frames: start must be 0, stop 1 and data+parity an odd number of ones, and the CPU
checks that (`decode_ps2_word` in `test/pio_tb_lib.py`); a bad frame is delivered as received.

*Idle-gap timeout.* While CLOCK stays high, x counts 32 iterations of 9 PIO cycles = 288 PIO cycles. If it
expires, `mov isr, null` discards a partial frame, so noise, hot-plug or a keyboard reset mid-byte cannot
leave the receiver misaligned forever. Choose CLKDIV so that 288 PIO cycles is about 100-300 us (longer than
the longest legal CLOCK-high time of about 50 us, shorter than the frame gap you want to resync on):
`CLKDIV ~ (100..300 us) * f_clk / 288`, e.g. 17..52 at 50 MHz. A complete frame clears the ISR by itself, so
back-to-back frames are unaffected. Frames that follow a partial frame with a shorter gap than the timeout stay
misaligned until the next long gap.

*Buffering and overflow.* The RX FIFO holds 4 frames. A make + break pair is up to 4 frames (`E0 F0 xx` plus
the make code), so the CPU must drain the FIFO at least once per 4 frames (a frame is 11 bit-times, 1.1 ms at
10 kHz, so about 4.4 ms). If the FIFO is full the autopush stalls the state machine: the four buffered frames stay intact, later
frames are lost, and the receiver resynchronises at the next idle gap (`test_ps2_rx_fifo_overflow_...`).

*What is tested* (`test/test_pio_protocols.py`, all at the `pio.v` level against `Ps2Keyboard` in
`test/pio_tb_lib.py`, a model that changes DATA while CLOCK is high, gives half a half-period of setup and
hold, and sends odd parity): keystroke traffic including extended keys and 0x00 / 0xFF / 0xAA; real rates
of 10 kHz and 16.7 kHz on the 50 MHz sim clock with CLKDIV 25; a 4-frame burst held while nobody reads the
FIFO; overflow and recovery; resync after a 5-bit partial frame; bad parity and a low stop bit reported to
the CPU; and SM1 receiving PS/2 while SM0 streams 96 bytes over SPI mode 0 out of the shared instruction
memory (`ps2_rx` loaded at origin 8; every one of the 1536 SCK edges happened during PS/2 frames). Mutation
checks: replacing `mov isr, null` with a jump, or making the timeout never expire, fails the partial-frame
test; shortening the timeout to `set x, 3` fails all five fast tests.

*Not done:* host-to-
device commands (LED set, reset), which need CLOCK/DATA driven open-drain on the `uio[5:4]` pins (pins 8/9)
instead of the read-only `ui_in[3]` / `ui_in[4]`; inhibiting the keyboard by holding CLOCK low for flow
control (same requirement); anything on a real keyboard. The modeled keyboard is my reading of the PS/2
timing, not a measured device.

#### Low-speed USB host engine (`pio/usb_ls.pio`)

One state machine, 29 of the 32 shared instruction words, no RTL change. D+ = PIO pin 8 (`uio[4]`),
D- = PIO pin 9 (`uio[5]`); both are bidirectional, and PINDIR is the real output enable, so the
bus is released (idle J from the external pull-up on D- and the host pull-downs) whenever the engine
is not transmitting. Clock: 8 PIO ticks per bit, so **24 MHz core clock and CLKDIV 2 give exactly
1.5 Mb/s** (12 MHz tick); this is why `info.yaml` / `src/config.json` now say 24 MHz (41.667 ns).
The first GDS run, at a relaxed 1 MHz target, reported a register-to-register limit of 21.5 ns
(46.5 MHz) in the slow corner, so 24 MHz leaves about 1.9x margin. **Confirmed by a GDS run at
41.667 ns:** worst setup slack +20.17 ns in the slow corner (1.08 V, 125 C; worst path 22.1 ns arrival,
register to register), +27.6 ns typical, +29.6 ns fast, no setup violations (TNS 0) in any corner;
worst hold slack +0.116 ns (fast corner), no hold violations; 0 Magic DRC, 0 routing DRC, 0 LVS errors,
0 antenna-violating nets. Synthesis, placement and routing came out identical to the 1 MHz run (same 36,601
cells, same 3,605 hold buffers, same wirelength) because nothing needed repair at the tighter period. Unchanged
design-rule advisories, not failures: 44 max-slew violations (slow corner only), 258 max-fanout and 1 max-cap
violations. The gate-level tests (12/12, 2,587 s) run the CPU and boot path plus one PIO smoke test
(`test_pio_postlayout_echo_and_pulses`: FIFOs, shifter, ISA decode, IRQ flags, clock divider, pin muxing through the pads,
see feature 18); the other PIO protocol programs and tests have only been simulated on RTL. That smoke test never executes `in`, `out`,
`set pindirs`, side-set, pin-conditioned `jmp`/`wait`, `out exec`, autopush/autopull or the input synchronisers, and never owns pads 8/9
(`uio_oe` is asserted constant), so the I2C-specific logic and its open-drain pads have no post-layout evidence from it (list in `CHANGES_feature18.md`). Feature 20 adds the signature test (`test_pio_postlayout_signature`) that does cover those forms and pads, and it **passed on the placed netlist** (gds run #65, 5-6 Oct 2026, push `79f0997`: gate-level 13/13, signature test 7,564 s, `gl_test` job 3 h 11 min, whole workflow 5 h 52 min). The programs for I2C, USB and SWD themselves are still only simulated on RTL; what now has post-layout evidence is the instruction forms and the open-drain pads they rely on.

*TX* (`tx_start`): FIFO word 0 = number of bits - 1, then the packet's bits LSB first, 32 per word.
The bits are the **logical, already bit-stuffed** bits including SYNC (`tools/pio_usb.py` builds
tokens, DATA0/1 and handshakes, with CRC5 and CRC16 checked against known USB vectors); PIO does
the NRZI encoding (0 = toggle, line state kept in ISR) and the EOP (SE0 for 2 bit times, J for 1,
release). *RX* (`rx_start`, entered automatically after TX): waits for the first K, samples both
lines every 8 ticks, NRZI-decodes, shifts bits in (first bit = MSB of word 0), and at SE0 pushes
the last partial word. The host (`pio_usb.decode_rx`) finds the exact length from SYNC, the PID
check and the CRC, and removes the stuffing. The TX-to-RX flip is in the PIO program, so the
device's reply (a few hundred clocks after the token's EOP) is caught with the CPU parked --
one flash-page switch of the CPU costs about 3000 clocks.

**Limits, measured and not hidden**
- *Receive clock tolerance is narrow.* The sample point is fixed after the first edge (there is no
  instruction left for per-transition resync). Against a device model whose bit clock is off by
  +-x %, an 8-byte DATA1 decodes for **-0.5 % < x < +0.8 %**; handshakes and short packets tolerate
  more. The USB spec allows +-1.5 % for a low-speed device, so a device with an RC oscillator can
  fail on long packets; crystal and resonator devices are fine. Per-transition resync is the
  obvious next step.
- *TX is FIFO-sized.* The 4-deep TX FIFO holds the count word plus 3 data words = 96 bits. A token
  (32 bits) and a handshake always fit; a DATA packet with more than about 5 payload bytes needs the
  CPU to push a word within ~1500 clocks of starting (one page switch is ~3000), or a deeper TX
  FIFO. So a full control transfer (SETUP token + 8-byte DATA0 back to back) is **not** possible
  from CPU firmware as is; IN/OUT tokens, handshakes and short data are.
- *RX is FIFO-sized too.* The worst-case 8-byte DATA packet (96 raw bits + stuffing) takes 4 words
  (128 bits) -- exactly the RX FIFO depth.
- *Electrical.* Nothing was measured; low-speed signalling is 3.3 V, so check the pad supply, add
  the 1.5 kohm pull-up (device role) or 15 kohm pull-downs (host role) and the series resistors on
  the board. Only the host-side engine exists; device-side response timing (7.5 bit times) was not
  attempted.

**Tests.** `test_pio_protocols.py` (+7): token waveform (every edge on a 16-clock boundary, SE0
exactly 32 clocks), DATA1 with 8 x 0xFF (maximum stuffing, no level longer than 7 bits), IN -> DATA1
turnaround, NAK, receiver alone (`rx_start`), 12 random packets, clock-error sweep. Model:
`UsbLsDevice` in `pio_tb_lib.py` (push-pull D+/D- with pull-down/pull-up idle, bit clock scalable).
`tb_pio_cpu_usb.v` runs the CPU image from `tools/build_pio_usb.py` end to end: token received
bit-for-bit by a Verilog device, the 4 RX words match, and the core had halted before the device
replied.

#### I2C slave and multi-master (feature 12)

Three more programs for the same state machines, no RTL change. All use SDA = PIO pin 8 (`uio[4]`),
SCL = PIO pin 9 (`uio[5]`), and the same PINDIR convention as `i2c.pio` (PINDIR = 1 pulls the line
low). Host-side helpers: `tools/pio_i2c_slave.py`, `tools/pio_i2c_mm.py`.

- **`pio/i2c_slave_rx.pio` (29 words), master writes to us.** START detect, 7-bit address compare
  (address held in Y), ACK, then exactly `WRITE_BYTES` data bytes, each ACKed and pushed to the RX
  FIFO (mask the word with 0xFF). A read request or another address is not ACKed. **Bounded on
  purpose**: while waiting for a data bit a PIO state machine cannot notice a STOP/START (there is no
  asynchronous branch), so a master that ends a write early would leave it out of step; fixing the
  length at assembly time avoids that. The OSR is used as a hardware bit counter.
- **`pio/i2c_slave_tx.pio` (32 words), master reads from us.** Address match, ACK, then bytes from
  the TX FIFO until the master NAKs. If the FIFO is empty when a byte is due, the state machine **holds
  SCL low** (side-set on the blocking `pull`) until the host supplies it: clock stretching with the CPU
  as slow as it likes (tested with 3000 clocks). Data words: `(~byte & 0xFF) << 24`.
- **`pio/i2c_mm.pio` (27 words), multi-master master.** The SDK program's structure plus bit-level
  arbitration: each data bit is carried twice in the FIFO word, a *drive* copy for `out pindirs` and a
  *tolerate-low* copy in X (forced to 1 for read bits), so releasing SDA for a 1 and reading 0 means
  "lost" only for write bits. On loss it lets go of SDA and SCL at once (IRQ 1) so the winner's byte is
  untouched; a NAK raises IRQ 0. After either IRQ the host must clear the FIFO, restart the SM and
  jump to `entry_point`. SCL high is held off until the wired-AND SCL is really high (clock
  synchronisation with slower masters). One SCL period = 32 PIO ticks (33 at CLKDIV 1).

**Limits.** *Speed:* the slaves need about 12 ticks after the 8th SCL fall to drive the ACK, so at
CLKDIV 1 an SCL period of 16 or 24 clocks is too fast (the master sees no ACK at the rising edge), 32
is the first that works; use 40 or more. *No combined slave:* a real sensor or EEPROM (write the
register pointer, repeated START, read) needs both directions in one device, but the two programs use
29 + 32 words of a 32-word instruction memory shared by all state machines, so they can only be
swapped at run time, not run together. *Not done:* a gate-level run of these programs themselves (the feature 18 smoke test and the feature 20 signature test run on the post-layout netlist and cover the instruction forms and pads they use, but not the programs).

**Limit: no bus-busy detection in `i2c_mm.pio`.** The program arbitrates bit by bit *after* a START and
synchronises SCL with slower masters, but nothing in it checks that the bus is free *before* the START,
and it does not follow START / STOP on the bus at all. A START is simply issued when the host queues one.
The model master in the tests does the check (SDA and SCL both high for `t_free` = 128 clocks); the PIO
master does not. Measured (`test_mm_busy_*` in `test_pio_protocols.py`; the other master is part-way
through a 4-byte write to the same slave, the PIO then writes `0x33`, SCL period 64 clocks):

| PIO START lands | what happens |
|---|---|
| 30 clocks after the other master's START (its address byte) | SCL is high and SDA released: the slave sees a **second START**, the other master's transaction is destroyed (all four bytes NAKed, the slave captured garbage) |
| 1500 clocks in (data byte 3) | same: second START, the other master's byte `0x55` reaches the slave as `0x6C`, its last two bytes are NAKed |
| 100, 200, 300, 450, 600, 900 clocks in | no damage: SDA was already low or SCL low at that moment, the PIO sees the other master's bits, flags *lost* and lets go |

Two things follow. First, the damage depends on where in the other master's bit the PIO's START edge falls,
so a bench that happens to pass is **not** evidence that it is safe (6 of the 8 timings tried were harmless).
Second, **IRQ 1 ("lost") does not mean the winner is unharmed**: in both destructive cases the PIO reported
"lost" as well, because arbitration only protects the data bits that follow the START, not the START itself.

*What the host must do.* Before queueing a START, read `PINS_IN` (bits 8 and 9 are SDA and SCL) until both
have been high for a bus-free time (the tests use 128 clocks; the I2C spec's t_BUF is 4.7 us in standard
mode, 1.3 us in fast mode, so the real number depends on the clock). After losing arbitration, do **not**
retry before the winner's STOP: wait for the same bus-free condition. With that wait the same eight timings
give two clean transactions every time (`test_mm_host_bus_free_wait_protects_the_other_master_*`: the other
master's four bytes arrive intact, then the PIO's write).
*What that does not cover.* (1) The check and the START are separate steps; with the CPU's page-switch cost
(about 3000 clocks) another master can start in between, and the same corruption follows -- the window is far
larger than the spec's START hold time, so a bus with several real masters needs the check inside the PIO
program. `i2c_mm.pio` uses 27 of 32 words; five are left, which should be enough for "wait for SDA and SCL
high, count a bus-free time, then START" ahead of the first START, **but this was not tried**. (2) Two masters
that START at the same moment is exactly what arbitration is for, and that is tested. (3) A bus held low by a
stuck slave never becomes free: the host needs a timeout and a recovery (nine SCL pulses), neither of which
exists here.

**Tests** (`test_pio_protocols.py`; 76 in all as of feature 17): 14 multi-master (5 arbitration/clock-sync, 5 more, 4 bus-busy), 12 slave (including `test_i2c_slave_scl_speed_limits`, which logs the SCL-speed table). Models: `I2cMaster`, `I2cMM`,
`I2cSlaveRx`, `I2cSlaveTx` in `pio_tb_lib.py` / the helper modules.

**CPU-driven slave demo.** `tools/build_pio_i2c_slave.py` + `test/tb_pio_cpu_i2c_slave.v`, one flash
image, one state machine, an external I2C master (the bench, SCL period 128 clocks). *Phase 1:* the CPU
loads `i2c_slave_rx` (address 0x42, 2 bytes), enables it and spins on `FSTAT.RXEMPTY`
(`PioHost.wait_rx_ready`); the master writes `A5 3C`, the PIO does every bit, the CPU pops both bytes.
*Phase 2:* after a delay for the master's STOP, the CPU computes byte + 1 in three RV32I instructions
each, wipes the state machine (disable, restart, FIFO clear, SDA released), loads `i2c_slave_tx`,
queues the two words and executes `EBREAK`. The master then reads two bytes and gets `A6 3D` with the
core halted. It exercises exactly the thing a combined slave would need and cannot have at 29 + 32
words: the CPU does the bookkeeping between two direction-specific programs. Mutation check: making
the CPU add 2 instead of 1 fails the bench (`read back a7 3e`).

**Mutation sweep of the slave programs.** `tools/i2c_slave_mutation_sweep.py` breaks `i2c_slave_rx.pio` / `i2c_slave_tx.pio` one line at a time (29 mutants: address compare, ACK polarity and release, byte count, sampling edge, clock stretching, NAK handling, START detection, ...) on a temporary copy of the project and checks that a slave test fails for each; all 29 are caught by an assertion. The first run found three holes in the tests, now closed (see `CHANGES_feature12.md`, last addendum).

**CPU-driven PS/2 receiver demo (feature 13).** `tools/build_pio_ps2_rx.py` + `test/tb_pio_cpu_ps2.v`.
The CPU loads `ps2_rx.pio` (CLKDIV 17: 288 PIO cycles x 17 = 4896 clocks = 204 us at 24 MHz, inside the
program's own 100-300 us rule), configures `IN_BASE = 4`, `JMP_PIN = 3`, autopush at 11 bits, enables it,
and **sleeps** for about 153000 clocks. Meanwhile the bench's keyboard types `A down, A up, B down, B up,
C down` (`1C | F0 1C | 32 | F0 32 | 21`) at a **real 10 kHz** (2400 clocks per bit at 24 MHz, DATA changing
mid-CLOCK-high, odd parity, 7200 clocks between frames). When the first four frames are in, the bench
looks inside the RX FIFO: all four are there intact (start 0, odd parity, stop 1, right data) with the CPU
still asleep. The CPU then wakes, drains four frames, polls for the other three, and writes each scancode
(`(word >> 22) & 0xFF`) to `uo_out`; the bench requires all 7 in order. This is the case the polled reader
(`build_ps2_reader.py`, one ~3000-clock flash page per CLOCK edge) could not handle: its 2400-clock edges
are shorter than one page switch.
*Mutation checks:* CLKDIV 2 (idle timeout 576 clocks, shorter than CLOCK-high) -> the receiver resyncs
mid-frame and the FIFO holds 0 frames (FAIL); the CPU decoding `>> 21` instead of `>> 22` -> every
scancode wrong (FAIL). Both restored byte-identical.
*Measured while building it:* the CPU's 2-instruction delay loop takes about **274 clocks per pass** in
these benches (qspi_div_sel = 0), not the ~14 the `delay()` helper assumed; `delay()` therefore over-waits by
about 27x (harmless for the earlier demos, which only needed protocols to finish), and the new
`PioHost.delay_iterations(n)` gives an exact pass count. The first version of this demo asked for 170000
clocks via `delay()` and slept for 4.6 million.
*Not done:* host-to-device commands (needs CLOCK/DATA open-drain on `uio[5:4]`), real-keyboard
measurements, scancode-to-ASCII on top of the receiver.

**WS2812 / SK6812 LED strips (`pio/ws2812.pio`).** Four instructions: the classic three-phase structure (`out x,1` on a low side-set, branch on the bit with the
rising edge, then a long or short high), with the delays chosen so both pulse widths sit near the middle of the datasheet windows. `SIDESET_BASE` is the data pin
(1 bit, not optional), no OUT pins; shifting is left (MSB first) with autopull at 24 bits (32 for RGBW), no autopush. The pixel word is `GRB << 8`: the 24 bits sent
are the top 24. The line idles LOW because the side-set also happens while `out` stalls on an empty FIFO, and a low of at least the strip's reset time latches the frame
(50 us for the classic parts, up to 280 us for newer WS2812B / SK6812 revisions -- from datasheets as I remember them; check yours).

| | ticks | at 24 MHz, CLKDIV 3 (tick 125 ns) | datasheet WS2812B |
|---|---|---|---|
| bit period | 10 | 1.25 us | 1.25 us |
| 0: high / low | 3 / 7 | 375 / 875 ns | 400 / 850 +-150 ns |
| 1: high / low | 7 / 3 | 875 / 375 ns | 800 / 450 +-150 ns |

Other clocks: `CLKDIV = f_clk / 8 MHz` (3 at 24 MHz, 6 at 48 MHz). `T1`/`T2`/`T3` are `.define`s at the top of the file.

*Feed rate: the limit that matters on this chip.* A pixel is 24 bits x 30 clocks = 720 clocks on the wire, but this CPU queues about one word per ~3000 clocks (flash
paging). A one-word-at-a-time feeder therefore leaves the line low for far longer than the reset time between pixels, the strip latches after EVERY pixel, and on a chain every
pixel lands on LED 0 (`test_ws2812_feed_gap_longer_than_reset_splits_the_frame`; the firmware variant `build_pio_ws2812.py --naive` shows a 41,772-clock gap and the testbench
fails on it). The way around it is the 4-deep TX FIFO: preload four pixels while SM0 is disabled, enable, and queue a fifth right away. That is what the demo does and what was
measured (5 pixels, longest gap inside the frame 21 clocks, i.e. none). By the same arithmetic a CPU-fed frame can reach perhaps 5-6 pixels; I demonstrated 5. Longer strips would
need a faster feed than this CPU provides, or a different program (for example one that repeats a single colour N times by itself) -- not built.

*CPU-driven demo (`tools/build_pio_ws2812.py`, `test/tb_pio_cpu_ws2812.v`).* The CPU sets `GPIO_OUT[0]` low (the pad is driven from there, by the boot LED counter, until `PIN_OWN` is
set), loads the program, hands the pad over, preloads four pixels, enables SM0, queues the fifth and halts. The testbench is a strip: it decodes every bit from the measured pulse
width and checks the five GRB values, exact 9 / 21-clock high times, exactly 120 pulses and no others, the pad low before and after the hand-over, the line low for 3027 clocks (126 us)
before the first bit, the longest in-frame gap far below the reset time, the core halted 2771 clocks before the last bit ended, and the line idle low afterwards. Negative images:
`--naive` (slow feeder) and `--bad-handover` (`GPIO_OUT[0]` high when the pad changes hands) make it fail; run with `vvp ... +img=<name>.hex`. A 126 us lead-in is enough to flush
whatever the boot counter put on the pad for a 50 us strip but NOT for a 280 us one: add `h.delay(...)` before the first push if yours needs it.

*Tests* (`test/test_pio_protocols.py`, strip model `Ws2812Strip` in `test/pio_tb_lib.py`; the strip decodes bits from pulse widths and treats a low of >= the reset time as the latch): single pixel with
exact timing and the datasheet windows, 8 pixels back to back with no extra clock at pixel boundaries, two frames each latched, a feed gap longer than the reset time splitting the frame, and 32-bit
RGBW pixels. Mutation checks: inverting the side-set polarity, a 3-tick `T2`, a 6-tick zero pulse, and a zero pulse that never drops all fail the tests (the 3-tick `T2` passes the two tests that do not
measure bit periods and fails the other three).

*Not done:* a real strip; level shifting (WS2812 data inputs typically want about 0.7 x VDD, so a 5 V strip usually needs a 3.3 V -> 5 V shifter -- I have not checked your strip); a DMA-like feed. (The repeat-colour program, the RGBW top-level demo and the 280 us-reset firmware were added in feature 17, below.)

*Feature 17 additions (`CHANGES_feature17.md`).* `pio/ws2812_repeat.pio` (15 words): a command is two TX words, `N - 1` and the pixel, and paints N identical pixels without any CPU feed (the test streams 300 pixels from one pair of words with the FIFO empty). The HIGH pulses are exactly those of `ws2812.pio`; the instructions that reload the pixel lengthen the LOW time to 4 / 8 ticks between pixels and 9 / 12 ticks between commands (after a 1 / after a 0, 125 ns ticks), outside the nominal T0L / T1L windows and untried on a real strip. `tools/build_pio_ws2812.py --rgbw` and `--reset-us 280` build the top-level firmware variants (32-bit pixels; a CPU busy-wait after `PIN_OWN` that keeps the line low 343 us for 280 us parts); `tb_pio_cpu_ws2812.v` takes `+bits=32` / `+reset_us=N` / `+img=`, and the 126 us default firmware fails the 280 us check as it should. `tb_pio_cpu_ws2812_repeat.v` runs it through the real top level: the CPU queues three runs (30 green, 20 red, 10 blue) with six FIFO words, halts, and the PIO sends the 60 pixels alone with every pulse as documented. `tools/ws2812_repeat_mutation_sweep.py`: 18 mutants, all caught.

**1-Wire master (`pio/onewire.pio`).** One open-drain line (DQ = PIO pin 8 = uio[4], external pull-up about 4.7 kOhm). `set pindirs, 1` pulls DQ low, `set pindirs, 0` releases it, `in pins, 1` reads it. Standard speed, 1 us tick (CLKDIV 24 at 24 MHz). 31 of 32 instruction words.

Each transfer is one FIFO word: bit 0 = op (0 reset, 1 transfer), bits [5:1] = n-1 (1..26 bits), bits [31:6] = data, LSB first; a read sends ones. Every command pushes exactly one RX word: for a reset, bit 31 is the presence level (0 = a device answered); for a transfer, the sampled bits (first slot in bit 32-n, last in bit 31).

| | PIO ticks (1 us) | spec |
|---|---|---|
| reset low | 530 | 480-960 us |
| presence sampled | about 69 us after release | 15-60 us delay + 60-240 us pulse |
| recovery after reset | 429 | at least 480 us before the next slot (reset tail plus command overhead) |
| write-1 / read slot low | 3 | 1-15 us |
| read sample point | 13 us after the fall | before the 15 us hold ends |
| write-0 low | 65 | 60-120 us |
| slot length | 70-71 | 60-120 us |

*Findings from the device model (`OneWireSlave`).* Read-0 hold margin: a device that releases the line after 10 or 12 us is read as a 1; 13 us and longer works. Clock tolerance: the fast limit is about CLKDIV 22.15 (-7.7 %, write-0 low drops below 60 us); the slow limit is about 27.7 (+15 %, the sample point passes the 15 us hold). The program needs a 24 MHz clock; at another clock, change CLKDIV so one tick is 1 us.

*CPU-driven demo (`tools/build_pio_onewire.py`, `test/tb_pio_cpu_onewire.v`).* The CPU resets the bus (LED_OUT = 0xA0 present / 0xA1 absent), sends READ ROM (0x33), reads 8 bytes and shows each on LED_OUT. The testbench decodes the bus itself, checks CRC-8 (poly 0x8C reflected), the reset and gap lengths, the command byte and all 64 read slots, and flags any slot violation.

*Not done:* overdrive speed, strong pull-up (needs a second pin), ROM search (CPU code on top of 1-bit transfers), a real device.

**VGA 640x480 colour bars (`pio/vga_frame.pio` + `pio/vga_line.pio`).** The Tiny Tapeout VGA Pmod hangs on `uo_out`: bits 0-2 = R1 G1 B1, bit 3 = VSYNC, bits 4-6 = R0 G0 B0, bit 7 = HSYNC (pinout from the Tiny Tapeout specs page). Two state machines at CLKDIV 1, so one PIO tick is one pixel clock; together they fill all 32 instruction words (23 + 9).

- *Line machine (SM1, `vga_line`, 9 words, all in the wrap).* Free-runs 800-tick lines: HSYNC low 96 ticks (three `set pins, 0 [31]`), back porch, `irq set 0` at tick 143, a counted delay for the rest. HSYNC is pin 7 (SET base 7, 1 pin). Every line raises IRQ 0.
- *Frame machine (SM0, `vga_frame`, 23 words).* Never counts clocks, only line IRQs: VSYNC falls on the IRQ of the last front-porch line and rises two IRQs later (exactly 1600 ticks), then 33 back-porch lines, 480 picture lines, 9 front-porch lines = 525 per frame. On a picture line it copies the ISR into the OSR and shifts out 8 bars of 3 bits (`out pins, 3 [14]` + two `nop [31]` + `jmp !osre` = exactly 80 ticks), then forces black. Because it follows the line IRQ, the picture starts at the same tick of every line (146) and no line is ever stretched. Colour pins are OUT pins 0-2; VSYNC and the black/blank level are SET pins 0-3.
- *The palette is data.* It lives in SM0's ISR (bar 0 in bits 31:29, MSB first). To change it the CPU pushes a word and forces `pull block`, `mov isr, osr` (0x80A0, 0xA0C7); the next picture line uses it. `tb_pio_vga.v` does this during the vertical blank and checks that frame N still shows the old palette and frame N+1 the new one.
- *Timing numbers.* 31.47 kHz / 59.94 Hz at 25.175 MHz (the standard pixel clock); at this chip's 24 MHz it is 30 kHz / 57.1 Hz, which many monitors accept but I have not tried one. The post-layout limit (about 46 MHz slow corner) leaves room for a 25.175 MHz clock from the demo board.

| | ticks | VGA 640x480 spec |
|---|---|---|
| HSYNC low | 96 | 96 |
| line | 800 | 800 |
| picture start (back porch 50) | 146 | 144 nominal (tolerant) |
| picture | 640 = 8 x 80 | 640 |
| VSYNC low | 2 lines | 2 lines |
| frame | 525 lines = 420000 | 525 |

*Verification.* `tb_pio_vga.v` (pio.v alone) is a VGA monitor model that counts every HSYNC period, pulse width, VSYNC pulse and frame length, checks all 480 picture lines bar by bar (exact colours, 80 clocks each, same start tick, black before and after) and that every other line is black, over three frames. `tb_pio_cpu_vga.v` repeats the measurement through the real top level: the CPU (image from `tools/build_pio_vga.py`) loads both programs, pushes the palette, starts both machines with one CTRL write and executes EBREAK. Mutation-checked: 9 one-line changes to the programs (HSYNC 95 ticks, a 32-line back porch, a 79-tick bar, a one-line VSYNC, an 8-line front porch, an 801-tick line, 479 picture lines, no palette reload, an IRQ one tick late) all fail the testbenches. `tools/vga_mutation_sweep.py` repeats this systematically with 23 one-line mutants of both programs (all caught; the first run found that no test noticed a missing blank after the last bar, because both palettes ended in black -- the second palette now ends in cyan). `tools/onewire_mutation_sweep.py` does the same for the 1-Wire master with 23 mutants (all caught; the first run found that no test looked at the RX word of a write, now checked; early read sampling is not testable with the model's ideal pull-up).

*Limits / not done.* Only the high colour bit of each channel is driven (8 colours at about two thirds brightness; the CPU cannot refresh a framebuffer, so there is no bitmap, and the demo is a fixed bar pattern with a programmable palette). No real monitor. 24 MHz gives 57 Hz rather than 60. Tearing-free per-frame palette changes need the CPU to write during the blanking interval; mid-frame changes would show as a colour change at the next picture line.

**Post-layout PIO smoke test (`test/test_pio_gl.py`).** A short cocotb test that runs in the RTL job and in the Tiny Tapeout gate-level job (`COCOTB_TEST_MODULES = test,test_pio_gl`). Through the real boot path (GPIO bootloader, hand-off stub, flash) it runs a host-built image (`tools/build_pio_gl_smoke.py`): SM0 (`pio/gl_echo.pio`) pulls a word, inverts and bit-reverses it and pushes it back; SM1 (`pio/gl_pulses.pio`) waits for IRQ 0 and sends a burst of 4 pulses on pad uo_out[7]. The CPU shows the echoed byte on the pads for three words, and the test checks the three values in order, 12 pulses of exactly 4 clocks high / 10 clock period, a low pad at the end and the expected `uio_oe`. It exercises the flattened PIO FIFOs, shifter, ISA decode, IRQ flags, clock divider, pin muxing and bus handshake in the placed netlist. Cycle budgets are generous because the gate-level QSPI runs at the slow default speed. **Result:** it ran in the real `gl_test` job on the post-layout netlist and passed, 12/12 tests in 2,587 s. CI time: this one test makes `gl_test` take about 50 minutes instead of about 6, which fits GitHub's default job limit (360 minutes).

**Post-layout PIO signature test (`test/test_pio_gl_sig.py`, feature 20).** A second cocotb test in the same two jobs (`COCOTB_TEST_MODULES = test,test_pio_gl,test_pio_gl_sig`), pins only like the smoke test. The CPU loads `pio/gl_sig0.pio` (17 words) and `pio/gl_sig1.pio` (14 words) with `tools/build_pio_gl_sig.py`, owns all ten pins (`PIN_OWN` = 0x3FF), and the test compares what appears on the pads with golden values. SM0 shows each intermediate result on uo_out[7:0]: `set`, `mov` with plain / `~` / `::`, `in pins` and `in x` (left shift), `out pins` / `out y` (left shift), `pull`, `push`, `irq set rel`, `jmp x--`, and, through eight host-supplied `out exec` words (two instructions each), `mov pins` from `~y` / `isr` / `status` / `y`, `set pins`, `in y`, `jmp x!=y`, `jmp !x` (not taken), `jmp pin`, `jmp y--`, `wait gpio` and `wait pin` with `IN_BASE`; a taken jump skips a `set pins` sentinel that would show on the pads if the jump failed. SM1 drives the open-drain pads 8 and 9 with side-set PINDIRS (optional side-set, clock divider 2.5), reads them back through the input synchroniser (pad 8 bypassed, pad 9 synchronised) and moves data through autopull (threshold 16) and autopush (threshold 8). The testbench holds `ui_in` = 0x6A and models the pull-ups on pads 8/9 (a pad reads low only while the chip drives it low). The test checks the exact `uo_out` sequence, the exact (output enable, output value) sequence of the two pads, and, shown byte by byte by the CPU after it releases the pins, the RX words (SM0 `push`, SM1 autopush: 0x93, 0xC3, 0x5A) and the IRQ flags. Golden values were worked out by hand from the instruction semantics and confirmed on the RTL simulation. *Evidence:* **passed on the placed IHP netlist** in the gds run #65 of 5-6 Oct 2026 (gate-level 13/13, 0 failures): 7,564 s and 4.40 million simulated clocks, against 3,444 s and 1.97 million for the smoke test in the same run (a ratio of about 2.2; my pre-run estimate of 1.9, from an RTL measurement, was low). It also passes on RTL (about 112,000 clocks with the fast QSPI setting) and on a Yosys-synthesized netlist of `src/`. The 20-million-clock default budget (`GL_SIG_MAX_CLOCKS`) is about 4.5 times what it needed. Cost: the `gl_test` job went from about 50 min to 3 h 11 min and the whole `gds` workflow took 5 h 52 min. `tools/gl_sig_mutation_sweep.py` breaks the programs and `pio_sm.v` / `pio.v` one line at a time: 38 of 40 mutants are caught. *Survivors:* the autopull threshold boundary (`>=` to `>` at the start of an `out`) and the STATUS source select (TX or RX level; the TX level at that moment depends on how fast the CPU pushes, so it is not used). *Not covered:* `jmp !y`, `out pindirs` / `pc` / `isr`, `mov exec` / `pc` / `isr` / `osr` destinations, `push iffull`, `pull ifempty`, `wait` that really stalls on a pin, and the timing difference between bypassed and synchronised pins (the delays leave margin). *Not done:* a cheaper variant (the cost is dominated by the CPU loading and reading the test through the slow QSPI flash, see `CHANGES_feature20.md`).

**SWD debug host (`pio/swd.pio`).** SWCLK = side-set pin 0 (uo_out[0]), SWDIO = PIO pin 8 (uio[4], `set pindirs` releases it, `in pins` samples it; needs an external pull-up, `PIN_OWN` = 0x101). 15 of 32 instruction words, one state machine, OUT and IN shift right. The program knows only two commands (header word: bits [4:0] = n-1, bit 5 = read): *write n bits* (the next FIFO word is the data, LSB first, SWDIO driven) and *read n bits* (SWDIO released, sampled on the last tick before every rising edge). Every command pushes one RX word (writes push 0 as a completion marker; a read returns its bits in the top n bits, so `word >> (32-n)`). Everything SWD-specific is built by the CPU from those two: a request is `wr(8, request)`, `rd(4)` (turnaround + 3 ACK bits), then for a read `rd(32) rd(1) rd(1)` (data, parity, turnaround) or for a write `rd(1) wr(32) wr(1)` (turnaround, data, parity); turnarounds are READ commands so the host never drives SWDIO while the target does. The JTAG-to-SWD switch is 64 ones, 0xE79E, 64 ones, 8 idle zeros. `tools/pio_swd.py` has the request byte, parity, command words and the DP / MEM-AP register addresses. Timing: 8 ticks per bit (SWCLK 4 high / 4 low, idle low), SWDIO changes when SWCLK falls (4 ticks of setup, 4 of hold), so at 24 MHz CLKDIV 1 gives 3 MHz SWCLK; CLKDIV is the speed control.

*Verification.* `test/test_pio_swd.py` (18 cocotb tests, pio.v alone) runs the host against `SwdTarget`, a protocol-strict SW-DP + MEM-AP model: it ignores everything until the switch, accepts only requests with start 1 / stop 0 / park 1 / correct parity, answers OK / WAIT / FAULT, sends read data + parity, checks the parity of write data, implements DPIDR, ABORT, CTRL/STAT (power-up request / acknowledge, STICKYERR, WDATAERR), SELECT, RDBUFF and a MEM-AP (CSW with auto-increment, TAR, DRW with posted reads, IDR), and flags any clock in which host and target both drive SWDIO. The tests cover the connect sequence (request byte 0xA5), the wire bytes of six DP accesses, power-up, memory read and write with auto-increment, WAIT retry (no data phase), FAULT / STICKYERR / ABORT, bad write parity (dropped, WDATAERR), bad read parity (host flags it), a request with bad parity (no answer), SWCLK and SWDIO timing, a CLKDIV sweep, command lengths 1..32 with bit order, the SYNC_BYP option, a full RX FIFO (SWCLK stays low) and a long mixed session. `tools/swd_mutation_sweep.py` breaks `swd.pio` 20 ways. Not done: a CPU-driven end-to-end demo through the top level (the packet logic is host code in the tests), and no real target has been tried.
