alexandercoabad/AgilA32_PIO/docs/info.md

<!---

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

## How it works

This is a minimal 32-bit RISC-V (RV32I) CPU written for this project. The CPU is written for this project, not derived from an existing open-source core; it follows the public RV32I specification, and the PIO follows the public RP2040 datasheet. It was developed by Alexander Co Abad with the help of Claude AI (Sonnet 5.5). Originally
inspired by [Pineapple ONE](https://pineapple-one.github.io/) -- a
RISC-V computer built entirely out of discrete 7400-series logic chips
(no FPGA, no microcontroller) -- the "just basic logic" idea of a
minimal RISC-V core is where this whole line of projects
started.

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

### What the boot ROM does

On every reset, the boot ROM (`tools/build_boot_rom.py`) runs first,
from `0x00`:

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

### Reprogrammability

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

#### Boot-timeout flash fallback

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

#### The FLASH_MODE handoff stub, and why flash byte 0 is dead

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

#### Bank-switched flash execution (FLASH_PAGE)

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

#### Driving an ST7789 display from flash

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

#### Reading a PS/2 keyboard from flash

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

#### Step 2: scancode -> ASCII translation

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

### Portability

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

## How to test

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

*PIO block tests, CI and mutation sweeps.* Besides the suites below, the PIO block has 95 cocotb protocol tests, 16 PIO Verilog testbenches
(12 of them CPU-driven end to end through the real top level) and five mutation sweeps (`tools/i2c_slave_mutation_sweep.py`,
`onewire_mutation_sweep.py`, `vga_mutation_sweep.py`, `ws2812_repeat_mutation_sweep.py`, `gl_smoke_mutation_sweep.py` (16), `gl_sig_mutation_sweep.py` (40); 29 + 23 + 23 + 18 one-line mutants, all caught; the signature sweep catches 38 of 40, see its test paragraph). `make standalone-tests` runs
everything; `.github/workflows/pio-tests.yaml` does so on every push (first GitHub run on 4 Oct 2026, push `5de56c9`: 76/76 cocotb tests passed, every bench log ending in PASS, 9 min 4 s), while `test.yaml` runs only `make`.
Everything above is simulation; none of the PIO protocols has been tried on real hardware or a real peer device.

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

## External hardware

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

#### PSRAM_BANK (RAM B)

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

#### Variable SPI clock divider

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

#### Generic SPI peripheral

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

`SPI_DATA` (`0xFD`) is the whole interface:

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

Resets to `0x00` (nothing has been clocked in yet).

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

#### Timer / PWM

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

**Timer** -- a free-running 16-bit up-counter:

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

**PWM** -- an 8-bit free-running PWM generator, sharing the same
free-running counter idea:

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

#### EBREAK halts the core

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

#### PIO -- firmware-defined protocol engines (UART / SPI / ...)

AgilA32 carries a **PIO block**: two state machines that execute the
RP2040 PIO instruction set (JMP WAIT IN OUT PUSH/PULL MOV IRQ SET, with
side-set, per-instruction delay, autopush/autopull, IRQ flags, and a
16.8 fractional clock divider), one shared 32-word instruction memory,
and a 4-deep TX and RX FIFO per state machine. Each state machine
executes one instruction per divided-clock tick with deterministic,
cycle-exact timing, so a protocol is *a short program loaded after
fabrication* -- nothing about UART, SPI, etc. is hard-wired. Programs
written for the RP2040 (Pico SDK `uart_tx`, `uart_rx_mini`, `spi_cpha0`
...) run unmodified when they stay on pins 0-9 (`pio/` holds three of
them; `tools/pioasm.py` assembles the stock `pioasm` syntax). The PIO block is an independent implementation of the RP2040 PIO instruction set, not affiliated with or endorsed by Raspberry Pi Ltd; some programs in `pio/` derive from the Pico SDK (BSD-3-Clause), see `NOTICE.md`.

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

#### Low-speed USB host engine (`pio/usb_ls.pio`)

One state machine, 29 of the 32 shared instruction words, no RTL change. D+ = PIO pin 8 (`uio[4]`),
D- = PIO pin 9 (`uio[5]`); both are bidirectional, and PINDIR is the real output enable, so the
bus is released (idle J from the external pull-up on D- and the host pull-downs) whenever the engine
is not transmitting. Clock: 8 PIO ticks per bit, so **24 MHz core clock and CLKDIV 2 give exactly
1.5 Mb/s** (12 MHz tick); this is why `info.yaml` / `src/config.json` now say 24 MHz (41.667 ns).
The first GDS run, at a relaxed 1 MHz target, reported a register-to-register limit of 21.5 ns
(46.5 MHz) in the slow corner, so 24 MHz leaves about 1.9x margin. **Confirmed by a GDS run at
41.667 ns:** worst setup slack +20.17 ns in the slow corner (1.08 V, 125 C; worst path 22.1 ns arrival,
register to register), +27.6 ns typical, +29.6 ns fast, no setup violations (TNS 0) in any corner;
worst hold slack +0.116 ns (fast corner), no hold violations; 0 Magic DRC, 0 routing DRC, 0 LVS errors,
0 antenna-violating nets. Synthesis, placement and routing came out identical to the 1 MHz run (same 36,601
cells, same 3,605 hold buffers, same wirelength) because nothing needed repair at the tighter period. Unchanged
design-rule advisories, not failures: 44 max-slew violations (slow corner only), 258 max-fanout and 1 max-cap
violations. **Update, gds run #122 (3 Nov 2026, CMOS5L flow, 8x4, action tag `@ttihp27a`, same RTL and `config.json`):** worst setup slack +20.60 ns in the slow corner (register-to-register limit about 47.5 MHz, roughly 2.0x margin at 24 MHz), +25.27 ns typical, +28.04 ns fast, TNS 0 in every corner; worst hold slack +0.109 ns (fast corner), no hold violations; 0 Magic DRC, 0 routing DRC, 0 LVS errors, 0 antenna-violating nets; advisories 183 max-slew (slow corner; 48 typical, 8 fast), 273 max-fanout and 39 max-cap violations. The gate-level tests (12/12, 2,587 s) run the CPU and boot path plus one PIO smoke test
(`test_pio_postlayout_echo_and_pulses`: FIFOs, shifter, ISA decode, IRQ flags, clock divider, pin muxing through the pads,
see feature 18); the other PIO protocol programs and tests have only been simulated on RTL. That smoke test never executes `in`, `out`,
`set pindirs`, side-set, pin-conditioned `jmp`/`wait`, `out exec`, autopush/autopull or the input synchronisers, and never owns pads 8/9
(`uio_oe` is asserted constant), so the I2C-specific logic and its open-drain pads have no post-layout evidence from it (list in `CHANGES_feature18.md`). Feature 20 adds the signature test (`test_pio_postlayout_signature`) that does cover those forms and pads, and it **passed on the placed netlist** (gds run #65, 5-6 Oct 2026, push `79f0997`: gate-level 13/13, signature test 7,564 s, `gl_test` job 3 h 11 min, whole workflow 5 h 52 min). The programs for I2C, USB and SWD themselves are still only simulated on RTL; what now has post-layout evidence is the instruction forms and the open-drain pads they rely on.

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

#### I2C slave and multi-master (feature 12)

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

- **`pio/i2c_slave_rx.pio` (29 words), master writes to us.** START detect, 7-bit address compare
  (address held in Y), ACK, then exactly `WRITE_BYTES` data bytes, each ACKed and pushed to the RX
  FIFO (mask the word with 0xFF). A read request or another address is not ACKed. **Bounded on
  purpose**: while waiting for a data bit a PIO state machine cannot notice a STOP/START (there is no
  asynchronous branch), so a master that ends a write early would leave it out of step; fixing the
  length at assembly time avoids that. **Measured cost of a short write** (N = 2, master sends 1 byte then STOP;
  `test_i2c_slave_rx_short_write_corrupts_only_the_next_transaction`): the short write itself is ACKed and delivered, the
  NEXT transaction is NAKed from its address on and one bogus byte (the previous address bits misread as
  data, `0x42` in the test) reaches the RX FIFO, and the slave then recovers by itself for the transaction after that. One
  scenario at SCL period 64, not a sweep. The OSR is used as a hardware bit counter.
- **`pio/i2c_slave_tx.pio` (32 words), master reads from us.** Address match, ACK, then bytes from
  the TX FIFO until the master NAKs. If the FIFO is empty when a byte is due, the state machine **holds
  SCL low** (side-set on the blocking `pull`) until the host supplies it: clock stretching with the CPU
  as slow as it likes (tested with 3000 clocks). Data words: `(~byte & 0xFF) << 24`.
- **`pio/i2c_mm.pio` (27 words), multi-master master.** The SDK program's structure plus bit-level
  arbitration: each data bit is carried twice in the FIFO word, a *drive* copy for `out pindirs` and a
  *tolerate-low* copy in X (forced to 1 for read bits), so releasing SDA for a 1 and reading 0 means
  "lost" only for write bits. On loss it lets go of SDA and SCL at once (IRQ 1) so the winner's byte is
  untouched; a NAK raises IRQ 0. After either IRQ the host must clear the FIFO, restart the SM and
  jump to `entry_point`. SCL high is held off until the wired-AND SCL is really high (clock
  synchronisation with slower masters). One SCL period = 32 PIO ticks (33 at CLKDIV 1).

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

**Tests** (`test_pio_protocols.py`; 77 in all with the short-write test): 14 multi-master (5 arbitration/clock-sync, 5 more, 4 bus-busy), 13 slave (including `test_i2c_slave_scl_speed_limits`, which logs the SCL-speed table). Models: `I2cMaster`, `I2cMM`,
`I2cSlaveRx`, `I2cSlaveTx` in `pio_tb_lib.py` / the helper modules.

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

**CAN 2.0A/B (`pio/can_tx.pio` + `pio/can_rx.pio`).** Two state machines, 20 + 10 = 30 of the 32 instruction words, an external CAN transceiver: TXD = PIO pin 0 (uo_out[0], recessive = 1, `PIN_OWN` bit 0, `set pins, 1` forced before the pin is handed over), RXD = PIO pin 1 (ui_in[1], `IN_BASE` = 1 and `JMP_PIN` = 1 on both machines). One bit is 16 ticks, so the bit rate is f_clk / (16 x CLKDIV): at 24 MHz CLKDIV 3 / 6 / 12 give exactly 500 / 250 / 125 kbit/s. **PIO has no XOR, so the CRC-15 and the bit stuffing are computed on the CPU** (`tools/can_frame.py`); the PIO does bit timing, bus readback and raw capture.

*Transmitter (SM0).* A command is the TX FIFO words `[n-1, ceil(n/32) data words]`, bits LSB first. The n strict bits are SOF .. CRC delimiter of the stuffed frame. Each bit: TXD changes on tick 2, the bus is read back on tick 14 (12 ticks = 75 % after the TXD edge); a mismatch aborts (sent recessive / read dominant = lost arbitration inside the arbitration field, otherwise a bit error; sent dominant / read recessive = bit error): TXD is released, the result word `0xFFFFFF00 | (255 - x)` is pushed (x = bits still to send, so the bad bit has index n-1-x) and the machine parks; the host disables it, clears the FIFOs, forces `jmp cmd` and enables it again (`CanHost.restart_tx()` in the tests). When all n bits matched, the PIO itself appends 12 bits: the ACK slot (recessive, read back: dominant = somebody acknowledged) and 11 recessive bits (ACK delimiter, 7 EOF, 3 intermission), and pushes the 12 samples (`word >> 20 & 1 == 0` means acknowledged). An error flag is the same command with n = 6 zeros. The command boundary costs no ticks: the whole frame is one command and further data words are pulled inside the bit loop with `pull ifempty`, so **the TX FIFO must never run empty inside a frame** (one word per 32 bit times; the CPU demo queues the whole 3-word command before it starts the machine).

*Receiver (SM1).* Waits for the falling edge of SOF, samples RXD 10 ticks later (about 75 %), then every 16 ticks, autopush every 32 samples, until 11 consecutive recessive samples (ACK delimiter + EOF + intermission, or an idle bus). It then pushes the partial word and a tag word `0xFFFFFFFF - (S-1)` (upper 24 bits ones, which no data word can have) and waits for the next SOF. It sees every frame on the bus including the chip's own. `can_frame.decode_capture()` destuffs, parses and CRC-checks a capture on the CPU; `can_frame.capture_words()` is a Python reference model of the RX program that the tests compare against word for word. There is no resynchronisation after SOF (the two clocks must agree to about 0.2 %: measured over a 133 bit frame, a node up to 0.19 % faster or 0.47 % slower is still captured correctly), no bus-idle detection before a transmission (the host must not start while a frame is on the bus; two nodes arbitrate correctly only if they start together), no automatic ACK of received frames (the PIO cannot decode in real time), no error counters or automatic error frames, no CAN FD. Loop delay TXD -> RXD of 0..7 clocks works including the ACK of a node that answers late; 9 clocks or more reads the SOF back as recessive and the frame aborts at bit 0.

*Verification.* `test/test_pio_can.py` (25 cocotb tests, pio.v alone) runs both machines against `pio_can_lib.CanBus` (wired-AND of TXD and the node outputs, RXD through a loop delay, fault injection) and `CanNode` models (hard sync, 75 % sampling, destuffing, CRC check, ACK, arbitration, error resynchronisation). The CRC-15 is checked against an independent GF(2) long division, stuffing against its rules (never more than 5 equal bits, worst-case frames), 3000 random frames round-trip through `parse_frame`; the TX tests put 8 frame types on the wire (standard, extended, remote, DLC 0..8, worst-case stuffing) and check TXD bit by bit with every edge on the 16-tick grid (integer and fractional CLKDIV), the ACK slot and the recessive tail, an unacknowledged frame, the error-flag command, three back-to-back commands (exactly 3 clocks between one frame and the next SOF), arbitration lost (abort index equals the first differing bit, TXD released, the winner's frame intact and captured by the chip, restart works) and won, arbitration at each of the 11 identifier bits, a glitch on a recessive data bit and an RXD fault on a dominant data bit (abort index, release, recovery), the loop-delay margin and `SYNC_BYP`; the RX tests capture every frame type word for word against the reference model, an unacknowledged frame, back-to-back frames at the minimum intermission, raw streams of 14..131 samples (all residues mod 32, empty partial word), an error flag, a stuff violation, a 7-word frame, the clock tolerance of the sampling point against a fast and a slow node, and a 14-frame mixed session. `tb_pio_cpu_can.v` runs it through the real top level: the CPU (image from `tools/build_pio_can.py`) configures both machines, sends ID 0x123 / DE AD, a bench node checks the wire bit for bit and acknowledges it, and the CPU reads back the RX capture of its own frame and of the next frame sent by the bench (its result byte and every word are compared with the reference model). `tools/can_mutation_sweep.py` breaks the two programs and `can_frame.py` 52 ways (all caught; the first full run had three survivors -- an ACK slot one tick long, a first RX sample one tick early, a CRC polynomial change -- which led to the exact back-to-back gap assertion, the clock-tolerance test and a reference that does not share the polynomial constant). First GitHub run (7 Oct 2026): 120/120 cocotb protocol tests, all 34 bench logs PASS, 9 min 35 s; the sweep has not been timed on GitHub. Not tried on a real CAN bus or transceiver.
