alexandercoabad/AgilA32_PIO/test/tb_pio_isa.v

// tb_pio_isa.v -- directed instruction-semantics test for the PIO state machine.
//
// Every instruction here is executed via the host INSTR register on a
// *disabled* state machine (host-forced instructions run regardless of
// SM_ENABLE), and the results are read back through the RX FIFO (MOV ISR,x
// then PUSH) or the ADDR / IRQ / PINS_OUT registers. Expected values are
// hand-derived from the RP2040 datasheet (section 3.4), not from the RTL.
//
// Instruction encodings used below (delay = 0, side-set = 0):
//   SET  x,n = E020|n   SET y,n = E040|n   SET pins,n = E000|n  SET pindirs,n = E080|n
//   MOV  dst,src = A000 | dst<<5 | op<<3 | src
//        dst: pins0 x1 y2 exec4 pc5 isr6 osr7   src: pins0 x1 y2 null3 status5 isr6 osr7
//        op : 0 none, 1 invert, 2 bit-reverse
//   IN   src,n = 4000 | src<<5 | n     (src: pins0 x1 y2 null3 isr6 osr7; n=0 means 32)
//   OUT  dst,n = 6000 | dst<<5 | n     (dst: pins0 x1 y2 null3 pindirs4 pc5 isr6 exec7)
//   PUSH = 8000 (|20 block, |40 iffull)   PULL = 8080 (|20 block, |40 ifempty)
//   JMP  cond,a = 0000 | cond<<5 | a   (cond: always0 !x1 x--2 !y3 y--4 x!=y5 pin6 !osre7)
//   IRQ  = C000 | clr<<6 | wait<<5 | idx     WAIT = 2000 | pol<<7 | src<<5 | idx

`timescale 1ns/1ps
`default_nettype none

module tb_pio_isa;
    reg         clk, rst_n;
    reg         valid, we;
    reg  [7:0]  addr;
    reg  [31:0] wdata;
    wire [31:0] rdata;
    wire        sel;
    reg  [9:0]  ext_in;
    wire [9:0]  pin_out, pin_dir, pin_own;

    `include "tb_pio_common.vh"

    pio #(.N_SM(2), .FIFO_LOG2(2)) dut (
        .clk(clk), .rst_n(rst_n),
        .valid(valid), .we(we), .addr(addr), .wdata(wdata),
        .rdata(rdata), .sel(sel),
        .pins_raw(ext_in),
        .pin_out(pin_out), .pin_dir(pin_dir), .pin_own(pin_own));

    // ---- helpers -------------------------------------------------------
    task ex;    input [15:0] ins; begin sm_exec(0, ins); end endtask
    task ex1;   input [15:0] ins; begin sm_exec(1, ins); end endtask

    // OUT EXEC / MOV EXEC leave the produced instruction pending; it executes in
    // place of the SM's next fetch, so briefly enable the SM (imem is all `jmp 0`).
    task run_pending;
        begin
            pio_wr(R_CTRL, 32'h0000_0001);
            repeat (8) @(posedge clk);
            pio_wr(R_CTRL, 32'h0000_0000);
            repeat (2) @(posedge clk);
        end
    endtask

    task get_x;   begin ex(16'hA0C1); ex(16'h8000); pio_rd(smreg(0, SM_RXF)); end endtask   // MOV ISR,X ; PUSH
    task get_y;   begin ex(16'hA0C2); ex(16'h8000); pio_rd(smreg(0, SM_RXF)); end endtask
    task get_osr; begin ex(16'hA0C7); ex(16'h8000); pio_rd(smreg(0, SM_RXF)); end endtask
    task get_isr; begin ex(16'h8000); pio_rd(smreg(0, SM_RXF)); end endtask                 // clears ISR

    task load_osr;                    // OSR <- v via TX FIFO + blocking PULL
        input [31:0] v;
        begin
            pio_wr(smreg(0, SM_TXF), v);
            ex(16'h80A0);
        end
    endtask
    task load_x;                      // X <- v
        input [31:0] v;
        begin load_osr(v); ex(16'h6020); end   // OUT X,32
    endtask

    task get_pc; begin pio_rd(smreg(0, SM_ADDR)); end endtask

    task set_shift;                   // in_right, out_right, push_thr, pull_thr, autopush, autopull
        input in_r; input out_r; input [4:0] pth; input [4:0] plt; input ap; input al;
        begin pio_wr(smreg(0, SM_SHIFT), shiftctrl(ap, al, in_r, out_r, pth, plt)); end
    endtask

    task fifo_clear; begin pio_wr(R_CTRL, 32'h0000_F000); end endtask

    integer i;
    reg [31:0] v;

    initial begin
        valid = 0; we = 0; addr = 0; wdata = 0; ext_in = 0;
        rst_n = 0; repeat (4) @(posedge clk); rst_n = 1; repeat (2) @(posedge clk);

        // ================= reset values (RP2040 datasheet) =================
        pio_rd(smreg(0, SM_CLKDIV));  check(rd_val === 32'h0001_0000, "CLKDIV reset = 1.0");
        pio_rd(smreg(0, SM_EXEC));    check(rd_val === 32'h0001_F000, "EXECCTRL reset: WRAP_TOP=31");
        pio_rd(smreg(0, SM_SHIFT));   check(rd_val === 32'h000C_0000, "SHIFTCTRL reset: both shifts right");
        pio_rd(smreg(0, SM_PINCTRL)); check(rd_val === 32'h1400_0000, "PINCTRL reset: SET_COUNT=5");
        pio_rd(R_CTRL);               check(rd_val === 32'h0, "CTRL reset: all SMs disabled");

        // ================= SET / MOV =================
        ex(16'hE03F & 16'hE03F | 16'h001F);            // SET X,31
        get_x; check(rd_val === 32'd31, "SET X,31");
        ex(16'hE047);                                   // SET Y,7
        get_y; check(rd_val === 32'd7,  "SET Y,7");
        ex(16'hA029);                                   // MOV X,!X
        get_x; check(rd_val === 32'hFFFF_FFE0, "MOV X,!X inverts");
        ex(16'hA052);                                   // MOV Y,::Y  (bit reverse)
        get_y; check(rd_val === 32'hE000_0000, "MOV Y,::Y reverses bits (7 -> E0000000)");
        ex(16'hA02B);                                   // MOV X,!NULL
        get_x; check(rd_val === 32'hFFFF_FFFF, "MOV X,!NULL = all ones");
        ex(16'hA043);                                   // MOV Y,NULL
        get_y; check(rd_val === 32'h0, "MOV Y,NULL = 0");
        ex(16'hA041);                                   // MOV Y,X
        get_y; check(rd_val === 32'hFFFF_FFFF, "MOV Y,X copies");

        // ================= OUT: shift right =================
        set_shift(1, 1, 5'd0, 5'd0, 0, 0);
        ex(16'hA0EB);                                   // MOV OSR,!NULL
        ex(16'h6028);                                   // OUT X,8
        get_x;   check(rd_val === 32'h0000_00FF, "OUT X,8 (right) takes the low byte");
        get_osr; check(rd_val === 32'h00FF_FFFF, "OSR shifted right by 8, zero filled");
        load_osr(32'hDEAD_BEEF);
        ex(16'h6040);                                   // OUT Y,32 (count field 0 means 32)
        get_y;   check(rd_val === 32'hDEAD_BEEF, "OUT Y,0 moves all 32 bits");
        load_osr(32'h1234_5678);
        ex(16'h6044);                                   // OUT Y,4
        get_y;   check(rd_val === 32'h0000_0008, "OUT Y,4 (right) = low nibble 8");

        // ================= OUT: shift left =================
        set_shift(1, 0, 5'd0, 5'd0, 0, 0);
        load_osr(32'h1234_5678);
        ex(16'h6028);                                   // OUT X,8
        get_x;   check(rd_val === 32'h0000_0012, "OUT X,8 (left) takes the top byte");
        get_osr; check(rd_val === 32'h3456_7800, "OSR shifted left by 8, zero filled");

        // ================= IN: shift right / left / count 32 =================
        set_shift(1, 1, 5'd0, 5'd0, 0, 0);
        ex(16'hA0C3);                                   // MOV ISR,NULL
        load_x(32'hAB);  ex(16'h4028);                  // IN X,8
        load_x(32'hCD);  ex(16'h4028);                  // IN X,8
        get_isr; check(rd_val === 32'hCDAB_0000, "IN right: newest byte enters at the top");
        set_shift(0, 1, 5'd0, 5'd0, 0, 0);
        ex(16'hA0C3);
        load_x(32'hAB);  ex(16'h4028);
        load_x(32'hCD);  ex(16'h4028);
        get_isr; check(rd_val === 32'h0000_ABCD, "IN left: newest byte enters at the bottom");
        load_x(32'hCAFE_F00D); ex(16'h4020);            // IN X,32
        get_isr; check(rd_val === 32'hCAFE_F00D, "IN X,0 (32 bits)");
        load_x(32'hFFFF_FFFF); ex(16'h4023);            // IN X,3 (isr was cleared by PUSH)
        get_isr; check(rd_val === 32'h0000_0007, "IN X,3 masks to 3 bits");

        // ================= PULL / PUSH edge cases =================
        set_shift(1, 1, 5'd8, 5'd8, 0, 0);              // push/pull thresholds = 8
        fifo_clear;
        load_x(32'd13);
        ex(16'h8080);                                   // PULL noblock, TX FIFO empty -> OSR <- X
        get_osr; check(rd_val === 32'd13, "noblock PULL on empty FIFO copies X into OSR");
        // IfEmpty when OSR not yet empty is a no-op
        load_osr(32'hAAAA_5555);                        // cnt = 0 (full)
        pio_wr(smreg(0, SM_TXF), 32'h1111_1111);
        ex(16'h80C0);                                   // PULL ifempty noblock
        get_osr; check(rd_val === 32'hAAAA_5555, "PULL IfEmpty is a no-op while OSR is not empty");
        pio_rd(smreg(0, SM_FLEVEL)); check(rd_val[2:0] === 3'd1, "IfEmpty no-op leaves the TX word queued");
        fifo_clear;
        // PUSH IfFull
        ex(16'hA0C3);                                   // ISR <- 0, cnt 0
        ex(16'h8040);                                   // PUSH iffull noblock : cnt 0 < 8 -> no-op
        pio_rd(R_FSTAT); check(rd_val[8] === 1'b1, "PUSH IfFull below threshold pushes nothing");
        load_x(32'h5A); ex(16'h4028);                   // IN X,8 -> cnt 8 == threshold
        ex(16'h8040);                                   // now pushes
        pio_rd(R_FSTAT); check(rd_val[8] === 1'b0, "PUSH IfFull at threshold pushes");
        pio_rd(smreg(0, SM_RXF)); check(rd_val === 32'h5A00_0000, "pushed ISR content (right shift)");
        // PUSH noblock on a FULL RX FIFO drops the data and clears ISR
        fifo_clear;
        for (i = 0; i < 4; i = i + 1) begin ex(16'hE021 + i); ex(16'hA0C1); ex(16'h8000); end
        pio_rd(R_FSTAT); check(rd_val[0] === 1'b1, "RX FIFO full after 4 pushes");
        ex(16'hA0C1);                                   // ISR <- X
        ex(16'h8000);                                   // PUSH noblock into a full FIFO
        pio_rd(smreg(0, SM_FLEVEL)); check(rd_val[6:4] === 3'd4, "PUSH into full FIFO must not overflow it");
        for (i = 0; i < 4; i = i + 1) begin
            pio_rd(smreg(0, SM_RXF));
            check(rd_val === (32'd1 + i) , "RX FIFO keeps the original 4 words in order");
        end
        // (X was set to 1..4 by SET X,(1+i)  ... SET X = E020|n so values 1,2,3,4)
        fifo_clear;

        // ================= eager autopull refill (datasheet 3.5.4.1) =================
        // After an OUT that drives the shift count up to PULL_THRESH the OSR is refilled
        // *immediately* from the FIFO if data is available, so !OSRE sees it as full
        // and the FIFO level drops now, not at the next OUT.
        set_shift(1, 1, 5'd8, 5'd8, 0, 1);              // autopull, threshold 8
        fifo_clear;
        pio_wr(smreg(0, SM_TXF), 32'hA1A2_A3A4);
        pio_wr(smreg(0, SM_TXF), 32'hB1B2_B3B4);
        ex(16'h80A0);                                   // explicit PULL -> OSR=A.., FIFO=[B..]
        ex(16'h6028);                                   // OUT X,8 -> cnt reaches 8 == threshold
        pio_rd(smreg(0, SM_FLEVEL));
        check(rd_val[2:0] === 3'd0, "autopull refills eagerly: TX FIFO drained by the OUT itself");
        get_x;   check(rd_val === 32'h0000_00A4, "OUT X,8 got the low byte of the first word");
        get_osr; check(rd_val === 32'hB1B2_B3B4, "OSR now holds the refilled word, count 0");
        ex(16'h00E5);                                   // JMP !OSRE, 5  : OSR full -> taken
        get_pc;  check(rd_val[4:0] === 5'd5, "JMP !OSRE taken right after eager refill");
        set_shift(1, 1, 5'd0, 5'd0, 0, 0);
        fifo_clear;
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
